fortunelabs-io/direct-semantic-comm/docs/dsc_first_principle.md

# Direct Semantic Communication on constrained hardware: a thinkbook

*Notes toward a two-node, two-sided, physically instrumented test of semantic payload transfer, written before any board has been flashed. Every number in this document that was not measured by this project is marked as borrowed. Borrowed numbers are expectations, not findings.*

---

## Preface

The parent build asked whether semantic enrichment via KV-cache transfer could be reproduced and fully understood from scratch, using models smaller than the paper's. It answered that question and produced a ledger: producing an enriched state is computation, moving it is communication, using it is computation again. It priced that ledger on a development machine and found the two sides pointing in opposite directions, compute favoring the exchange and communication opposing it by four to five orders of magnitude, with no way to adjudicate between them, because on that machine communication cost nothing.

What a development machine can produce is not a verdict but a threshold: the link speed above which the trade turns favorable, stated against both prompt and response length. That threshold is the last of the parent build's open items, recorded there as *the ledger reopened on constrained hardware, where the payload figure stops being free and the break-even table stops being arithmetic*.

This document is that item. It is not a derivative project. It is the only measurement that can adjudicate a question the parent build was structurally unable to answer.

The subject is no longer the KV-cache. The KV-cache does not fit on a microcontroller and neither does the machinery around it. What carries over is the shape of the trade the KV-cache experiment instantiated: whether transferring a representation that has already been understood is cheaper, in measured joules and milliseconds, than transferring raw data and forcing the receiver to understand it again.

One discipline carries over unchanged. No claim enters this document without either a local measurement or a citable source, and the two are never confused. The hardware harness described here is the physical analog of a capture script: until it runs on this project's own boards, every figure below is literature.

A second discipline carries over from the parent build's own failures. Predictions are recorded before the run that adjudicates them, in Section 7. Readings that measurement overturns are kept visible, not quietly corrected, because a claim that was corrected is worth as much as one that held.

---

## 1. Problem statement

Two microcontrollers share a low-power radio link. Node S has produced some internal state, a reading, a signal, a partial computation, sitting in its own SRAM. Node R needs to act on what that state means. Getting meaning from S's SRAM into R's decision requires one physical act: serialize the state into a payload, hand it to the radio, let the radio cut it into frames small enough to fit the link's hardware limit, transmit those frames one at a time, and let R reassemble and interpret them.

### 1.1 Why there are exactly three options

The choice of what to serialize is not a matter of taste, and it is not specific to microcontrollers. It is the composition question, and it has a known shape.

Combining the strengths of two systems requires choosing *where in the pipeline* the combination happens, and two classical answers occupy the endpoints. One communicates before computation, at the level of inputs or parameters: cheap to move, but the receiver must do all the work, and any work the sender already did is discarded. The other communicates after computation, at the level of outputs: minimal to move, but every contribution except the final one is destroyed at the source. Both endpoints are taken. Neither considers the middle.

Mapped onto the link, those endpoints are the first two options and the middle is the third:

1. S serializes its raw observation, unprocessed. R receives it and computes the result itself, from zero.
2. S computes the result fully, then serializes only the final decision, a single value or label.
3. S serializes an intermediate representation, distilled from the raw observation but not yet collapsed into a final decision.

The middle option is only viable if three things hold: there is an intermediate state rich enough to be worth transferring, that state is detachable from the process that produced it, and the receiver can interpret it despite not having produced it. A learned encoder satisfies the first two by construction, since a bottleneck activation is fully formed at a natural boundary and can be serialized. The third is the whole difficulty, and Section 3 splits it out as a separate hypothesis rather than assuming it away.

### 1.2 Why the middle is forced here rather than merely preferred

On a server the choice is unforced; both compute and bandwidth are cheap enough that any of the three works adequately. On an MCU pair two constraints bind at once and cannot be traded against each other in the usual way. First, the radio has a hard per-frame payload ceiling, and every frame, however small its contents, carries a fixed cost. Second, both S and R run on a milliamp-scale energy budget with no slack to spend on work that does not strictly have to be done.

Option 1 fails this pair in a specific way. Raw data is usually the largest of the three payloads, so it pays the most in frame overhead, and R still has to spend its own scarce energy reprocessing data that S may already have touched once. It is a double tax, paid on both ends of the same constrained link.

Option 2 fails differently, and the closest precedent concedes the failure in its own limitations section: processing on the device rather than sending means the raw data is lost for any later review, verification, or reanalysis, and where those are required the approach is unsuitable. That is not an outside criticism. It is the strongest existing measurement of Option 2 naming what Option 2 costs.

Option 3 is the only point in this design space where the cost paid at S, the cost paid on the link, and the cost paid at R can all be tuned together against the same two binding constraints, rather than relieving one by making the other worse.

### 1.3 The question

> On two ESP32-S3 nodes linked by ESP-NOW, does a learned intermediate representation clear both binding constraints at once, in measured joules and milliseconds, once the sender's encode cost and the receiver's decode cost are both charged against the frames it saves?

Everything below serves that question.

---

## 2. The gaps

Each gap is stated with the closest existing work and what that work stops short of. Where an earlier draft of this document overstated a gap, the correction is kept visible rather than silently applied.

### 2.0 Three constraint regimes, not one field

Three literatures look adjacent and are not, because each is pinned by a different binding constraint. Naming them first prevents the rest of this section from reading as three complaints about one body of work.

Split inference on MCUs (Lu et al., arXiv:2605.09357) is pinned by **peak RAM**. Its answer, sub-layer partitioning that bounds per-device memory, follows from that constraint and does not transfer, because its link is wired Ethernet and its metric is latency.

Embedded ML versus transmission (Karic et al., arXiv:2510.24829) is pinned by **transmission energy on one node**, the sensing node, and its answer is to send a class index over an LPWAN.

This project is pinned by **frame overhead and a two-sided energy budget on a connectionless short-range radio**. That is a third regime. The gaps below are consequences of it, not deficiencies in work that was answering something else.

**Gap 1: No two-sided ledger.** Karic et al. measure energy only on the sensing node. Their own text concedes that in the cloud-inference scenario only the IoT node is metered. The receiver's cost of consuming raw data versus consuming a distilled result is never measured anywhere in that line of work. The core claim of semantic communication is precisely a claim about the *sum* of both sides; a one-sided measurement cannot confirm or refute it.

**Gap 2: No representation between raw and decision, over a radio, with both sides metered.** Karic et al. transmit a class index: the final decision, Option 2 above. Lu et al. do transfer intermediate activations between MCUs, but over 100 Mbps wired Ethernet with TCP, through a PC coordinator, with no energy measurement anywhere; their own cost model has a compute term and a per-kilobyte communication term and no fixed per-transfer term at all. The intermittent-network study (arXiv:2512.24179) does move activations over ESP-NOW and does profile transmission energy, on one node, in a simulation-feeding profile. Nobody has transferred a learned intermediate representation between two MCUs over a radio while metering both nodes against a stated cost model.

*Correction to an earlier reading.* An earlier draft asserted that the split-inference line does not meter the radio at all. That is wrong for arXiv:2512.24179, whose Section 5.3 is a transmission energy profile per layer output over ESP-NOW. The gap survives in the narrower form stated above.

**Gap 3: No fragmentation curve.** This is now a statement about what two sources contain, not an absence of evidence.

The one peer-reviewed power-analyzer characterization of ESP-NOW found (Urazayev et al., IEEE SIST 2023) fixes its payload at **8 bytes** for every experiment. It is one point. There is no sweep.

Five further discrete points exist in the profiling appendix of arXiv:2512.24179, spanning payload sizes that straddle the ESP-NOW v1.0 single-packet boundary. They do not constitute a curve. There are no repetitions and no confidence bands; the sequence is non-monotonic in payload size with no explanation offered; two of the five rows fail an internal consistency check, in that the reported duration multiplied by the reported average power does not reproduce the reported total energy; and that paper's body text states a full-inference compute figure differing from the sum of its own layer-wise table by three orders of magnitude.

No published source provides a continuous, repeated, confidence-banded curve of energy per packet, or energy per byte, versus payload size across that boundary. The step structure at the fragmentation boundary, which is where the packet-count argument for semantic compression lives or dies, has never been drawn from measurement.

**Gap 4: No protocol match.** The LPWAN protocols in Karic et al. carry connection-establishment costs that dominate their energy profiles and have no analog in ESP-NOW; in their own measurements, network connection is the largest single term for the cellular protocols by a wide margin over the transmission itself. Their numbers do not transfer, and the term that dominates them does not exist here. Urazayev et al. establish that ESP-NOW undercuts a Wi-Fi TCP approach on power by more than thirty percent, and characterize a single transmission and its retransmission window, but at one payload size only.

**Gap 5: No cross-geometry bridging test on MCU pairs.** Every embedded precedent found here uses one designer's model split across devices, with encoder and decoder always optimized together. None tests the hard problem: a representation produced by one independently trained system, made usable by a second independently trained system through a small learned bridge, with both original systems frozen. Gaps 1 through 4 are closed by testing one jointly optimized system split across two devices. Gap 5 is closed only by a separate, later test where the two halves are trained independently and bridged, a deliberately narrower and later target than the first four.

**Gap 6: The compute cost of semantics is named but never priced.** The generalized semantic communication framework (Qin et al.) tabulates a cost row for semantic processing, listing sensing hardware, storage, and GPU, alongside its architectural framework. The theoretical survey (Xin, Fan and Letaief, *Entropy* 26(2):102) lists scheduling and energy optimization as an open challenge of semantic communication systems in its own words. The field names the computational price of semantics as a category and, so far as this search found, never pays it in joules on hardware where it binds. That is the space this project occupies, and it is a stronger positioning claim than novelty of mechanism.

A search across the semantic communication literature (Tsinghua, SJTU, XJTU groups), the split-computing literature, and the embedded ML literature found no work occupying the intersection of these gaps. The claim is not "this has never been done anywhere"; it is "this has not been found after a deliberate multi-tradition search." The distinction matters and is kept.

---

## 3. The proposed solution

The proposed solution treats Option 3 from Section 1 as two separate hypotheses, tested in sequence, never merged under one label.

**H_ledger** proposes splitting one jointly optimized encoder-decoder system across two physical devices. Encoder and decoder share one training objective by construction, so there is no representation-alignment problem to solve here, only a hardware cost to price.

- *Question*: does splitting one jointly trained encoder-decoder system across two physical nodes cost less, energy and latency on both sides, than sending raw data and having the receiver reprocess it, at equivalent delivered information?
- *Expected result*: H_ledger holds if $C_B < C_A$ per the inequality in 4.4, and $Q(B) \geq Q(A) - \varepsilon$ holds per sample under the sufficiency and collapse checks in 4.6. The boundary is not the sign alone; it is whether the measured margin matches the inequality's predicted direction and magnitude, reported as a fraction of the achievable range per 4.5.

**H_transfer** proposes the harder mechanism: a representation produced by one system that was never trained with the consumer in mind, made usable by a second, independent system through a small learned bridge. This is the variant with the alignment problem in it.

- *Question*: can a representation from an independently trained, frozen Encoder_S be made usable by an independently trained, frozen Decoder_R through a small trained Projector, at a bridging cost ($E_{\mathrm{proj}}$) that still leaves the total ledger favorable against raw transfer?
- *Expected result*: H_transfer holds if $C_{\mathrm{transfer}} < C_A$ per the inequality in 4.8 and the sufficiency and collapse checks pass. Because $E_{\mathrm{proj}} \geq 0$, this boundary is strictly tighter than H_ledger's; a small negative margin here is a meaningful failure in a way it would not be for H_ledger.

H_ledger is tested first, in Stages -1 through 4. H_transfer is tested second, in Stage 5, once the physical ledger itself is trusted. A result for H_ledger is not a result for H_transfer; the two are reported separately throughout.

One experiment, two conditions, four measured phases, both nodes metered.

**Condition A (raw transfer).** S transmits the raw payload. R receives it and runs the full processing step locally. The full processing step is the Condition B encoder and decoder at the contract point, run whole on R, per `2026-09-26-condition-a-runs-the-same-network-whole-on-r.md`. The two conditions then differ only in where the encoder runs and in what crosses the link. S pays no encode cost. The link pays for every raw byte, fragmented as needed. R pays full processing. At the contract point the compute premium of 4.4 is therefore close to zero, and H_ledger there measures the link saving almost alone. A model trained on raw data for R alone is a later sensitivity arm.

**Condition B (semantic transfer, H_ledger variant).** S runs a small learned encoder over the raw payload and transmits the latent representation. R runs the matching decoder, or consumes the latent directly for the task. S pays encode. The link pays only for the latent. R pays a reduced use cost. Encoder and decoder are trained together as one system and only split at deployment, so there is no representation-alignment problem here by construction.

### 3.1 The latent width is a design variable, and that is the premise of the whole argument

At the model tier the payload size is not a choice. A KV-cache is a consequence of architecture, of layer count, head count, head dimension, and precision, and cannot be tuned below any threshold. That is why the communication side of the parent build's ledger lost by four to five orders of magnitude with nothing available to do about it.

At this tier the bottleneck width is free. The latent can be sized and quantized to land wherever the designer puts it, including deliberately just under the frame limit $L$. The cut is fixed at an injected bottleneck, per `2026-09-26-search-space-is-bottleneck-width-and-bit-width.md`, so the width and the bit-width are the two design variables, and 4.9 states the search over them.

This is not a convenience. It is the premise on which the packet-count argument rests. The sawtooth in energy per byte is only *actionable* because there exists a design variable that can be placed on the cheap side of a discontinuity. Without that freedom the sawtooth would be an observation about a curve; with it, the sawtooth is a design target. Section 4.4 states the win condition in those terms.

### 3.2 R holds no local observation, and the replacement lesson does not transfer intact

In the parent build the consumer had its own reading of the same input, and the mechanism that worked added to it while every mechanism that substituted for it collapsed, twice, under two objectives, on two corpora, onto two different constant outputs. The lesson recorded there is that transferred understanding must complement and never overwrite.

That lesson does not transfer here in its stated form, and assuming it does would misdesign this experiment. The collapse observed there is destructive interference, and it requires the consumer to possess prior competence for the incoming representation to destroy. In Condition B and in Stage 5, R never observes the raw phenomenon. It has no competing reading to be overwritten, so there is nothing for a residual to preserve and substitution destroys nothing.

What does transfer, fully, is the *failure signature*: an output that collapses to a constant while an aggregate metric reads the collapse as partial success. That is not a property of substitution. It is a property of aggregate reporting, and it is guarded against in 4.6 rather than designed around here.

Giving R a cheap local observation would make this experiment a structural analog of the parent build's fused arm rather than its replacing arm, and that remains an interesting variant. It is not a correction, and it is not adopted in the core runs, because it changes the question from *what does a transferred representation cost* to *what does a transferred representation add*.

### 3.3 The encoder

The learned encoder is deliberately modest: an int8-quantized autoencoder of the kind already demonstrated on ESP32-class hardware. Novelty is not sought in the model. It is sought in the ledger.

Its energy is budgeted by measurement and never by operation count. The closest precedent measured a network with more floating-point operations consuming less energy than one with fewer, on this chip family, which is sufficient to retire the practice of estimating $E_{\mathrm{enc}}$ from FLOPs anywhere in this document.

### 3.4 Build discipline

Unix discipline governs the build. Each firmware and host component does one thing:

- `payload_gen`: produces payloads of a commanded observation size and content class. Nothing else.
- `fragmenter`: chunks a payload into ESP-NOW frames with one frame byte on each and a six-byte message header that holds a 16-bit sequence number and a CRC16, then reassembles and checks the message on the far side, per `2026-09-26-escp-header-layout.md`. Nothing else. Hand-rolled, so its compute cost is visible and chargeable, not hidden in a vendor component. The sequence number also carries the application-layer acknowledgement 4.6 requires, since a MAC-layer send success is not an application-layer delivery.
- `phase_marker`: toggles one GPIO per phase transition. Nothing else. This is not stylistic minimalism. The ESP-NOW send callback runs from a high-priority Wi-Fi task and the vendor documentation states that lengthy operations must not happen there, so the marker must be a bare register write and the analysis must happen on the host.
- `tx_role` / `rx_role`: two firmware images, one role each. No dual-mode switches. Ablation variants of each, per 4.2, are separate images rather than compile-time flags on one image.
- `meter_logger` (host side): reads the current trace and the GPIO edges, emits one CSV row per event. Text output, because text composes.
- `analyze` (host side): consumes CSV, emits statistics and plots. Never touches hardware.

Components communicate through flat files and serial text. Any single component can be replaced or audited without touching the others.

---

## 4. The mathematics and the architecture

### 4.1 Cost model

Let $p$ be payload size in bytes and $L$ the single-frame limit (`ESP_NOW_MAX_DATA_LEN`, 250 B under v1.0; `ESP_NOW_MAX_DATA_LEN_V2`, 1470 B under v2.0). Packet count is a ceiling function:

$$n(p) = \left\lceil \frac{p}{L} \right\rceil$$

That count is header-free. The ESCP header of `2026-09-26-escp-header-layout.md` puts `h_frag = 1` byte on every frame and `h_msg = 6` bytes once per message, so the count and the bytes on the wire become

$$n(p) = \left\lceil \frac{p + h_{\mathrm{msg}}}{L - h_{\mathrm{frag}}} \right\rceil, \qquad p_{\mathrm{wire}} = p + h_{\mathrm{msg}} + n(p)\,h_{\mathrm{frag}}$$

Every byte term in this document reads `p_wire` in place of `p`. The constants are fitted against `p_wire`, so no header byte is counted twice. The first frame boundary sits at `p = L − 7`, 243 bytes under v1.0 and 1,463 bytes under v2.0.

Transmit-side energy is modeled as three terms, not two:

$$E_{\mathrm{tx}}(p) = E_{\mathrm{wake}} + n(p)\cdot E_{\mathrm{pkt}} + p \cdot e_{\mathrm{byte}}$$

$E_{\mathrm{wake}}$ is everything paid once per *event* regardless of how many frames it takes: leaving sleep, bringing up the radio, the active window the MCU holds open, re-entering sleep. $E_{\mathrm{pkt}}$ is everything paid once per *frame*: preamble, the 43 bytes of ESP-NOW framing, the send callback, and whatever retransmissions the frame incurs. $e_{\mathrm{byte}}$ is the marginal air-time cost per payload byte at the configured PHY rate.

The receive side gets the mirrored model with its own constants:

$$E_{\mathrm{rx}}(p) = E'_{\mathrm{wake}} + n(p)\cdot E'_{\mathrm{pkt}} + p \cdot e'_{\mathrm{byte}}$$

**Why the wake term is separated.** An earlier version of this model folded the per-event cost into the per-frame term, and it could not have detected the difference, because a design in which every event is one wake confounds them exactly. The separation matters for three reasons.

The first is diagnostic. The only existing ESP-NOW energy data is consistent with a large fixed term of roughly the size of an active window multiplied by an idle current, and the only power-analyzer characterization puts an actual 8-byte transmission at about one millisecond, two orders of magnitude below that fixed term. If that reading is right, the dominant cost is *how long the MCU stays awake* rather than *how many frames it sends*, compute time and radio time compete for the same term, and the packet-count argument weakens sharply.

The second is that the wake asymmetry is not an open question but a protocol guarantee. Espressif's connectionless power-save model gives each connectionless module a Window and an Interval: at the start of each Interval, RF, PHY and BB are turned on and held for Window. The documentation states that transmission is supported at any sleeping time with no extra configuration, while reception requires the Window. **The sender can speak from sleep; the receiver must hold a window open to hear.** So $E'_{\mathrm{wake}}$ on R is a parameter this experiment sets rather than a property it discovers, it is independent of payload, and it is structurally unlike $E_{\mathrm{wake}}$ on S.

The third is structural, and it is the reason this separation is a decision rather than a refinement. The wake terms appear identically in both conditions and therefore *cancel in the difference*. They do not cancel in the range the difference is measured against. A term that the sign of the result normalizes away can still determine how much the result is worth, and reporting only the sign hides exactly that. Section 4.5 makes the range explicit.

**A note on $n(p)$ under v2.0.** The frame format documentation states that a v2.0 packet carries its payload as up to six vendor-specific elements, each with a seven-byte header and a body capped at 250 bytes. The 250-byte structure therefore does not disappear under v2.0; it moves from frame count into element count inside a single frame. Whether element count carries any cost beyond its seven bytes is unknown and is what the Stage 4 version control tests.

Total cost per delivered observation, both conditions:

$$C_A = E_{\mathrm{tx}}(p_{\mathrm{raw}}) + E_{\mathrm{rx}}(p_{\mathrm{raw}}) + E_{\mathrm{proc}}$$

$$C_B = E_{\mathrm{enc}} + E_{\mathrm{tx}}(p_{\mathrm{lat}}) + E_{\mathrm{rx}}(p_{\mathrm{lat}}) + E_{\mathrm{use}}$$

where $E_{\mathrm{proc}}$ is R's full processing of raw data, $E_{\mathrm{enc}}$ is S's encoder pass, and $E_{\mathrm{use}}$ is R's consumption of the latent. The same structure holds with $T$ substituted for $E$ throughout; energy and latency are two ledgers over one event stream.

### 4.2 How the terms are identified

Every quantity in 4.1 is identified by **experimental design across runs**, not by resolving the shape of the current inside one event. This is stated here, before the architecture, because it is what determines how much instrument the project needs.

**$E_{\mathrm{wake}}$ and $E_{\mathrm{pkt}}$: regression on $k$ payloads per wake window.** At fixed payload size, vary the number of payloads sent inside one wake window over $k = 1, 2, 4, 8, 16$ and measure the total energy of each whole event. The intercept is $E_{\mathrm{wake}}$ and the slope is $E_{\mathrm{pkt}}$. Each point is an integral, not a waveform. The vendor documentation requires waiting for each send callback before the next send, so $k$ scales wall-clock time and the fit must include that.

**$e_{\mathrm{byte}}$: the payload sweep.** Slope of total event energy against $p$ within a frame. Again integrals.

**The retransmission share of $E_{\mathrm{pkt}}$: broadcast against unicast.** ESP-NOW unicast expects an acknowledgement and retransmits, up to ten times by default and up to thirty-one if configured; the only power-analyzer characterization found puts a failed transmission's retransmission window at roughly twelve milliseconds against a successful transmission of roughly one. ESP-NOW broadcast is not acknowledged and therefore does not retransmit. **Running the same sweep in both modes isolates the retransmission term from the frame term.** It costs nothing but a change of peer address and it attacks the largest unexplained quantity in the borrowed data.

**$E_{\mathrm{enc}}$, $E_{\mathrm{proc}}$, $E_{\mathrm{use}}$: firmware-variant ablation.** Rather than segmenting one event into phases, run separate firmware images that perform strict subsets of the event, on identical wake and sleep structure, and difference their totals. An encode-only image and a transmit-only image, differenced against the full Condition B image, give the encode term without ever requiring the meter to resolve where encode ends and transmit begins. Short operations are measured by repeating them a commanded number of times within one event and taking the slope, which is more accurate than any single-shot capture would be.

**Consequence.** The critical path of this experiment is the *number and design of runs*, not the bandwidth of the instrument. The meter must integrate an event faithfully. It does not have to draw one. Section 4.7 states what that buys and what it costs.

### 4.3 Every energy figure is reported decomposed

No total is reported without its decomposition into the part that scales with payload and the part that does not, and the two must sum to the measured total with the residue stated explicitly. A residue that is not near zero is a modeling error, and it is found here or it is found nowhere.

This is the physical form of a discipline the parent build arrived at one tier up, where a falling total loss coexisted with a rise in the only component that could change an answer. A total that improves is not evidence that the mechanism under test did anything.

### 4.4 The claim under test

Semantic transfer wins if and only if:

$$E_{\mathrm{enc}} + E_{\mathrm{use}} - E_{\mathrm{proc}} \;<\; \left[ n(p_{\mathrm{raw}}) - n(p_{\mathrm{lat}}) \right]\left( E_{\mathrm{pkt}} + E'_{\mathrm{pkt}} \right) + \left( p_{\mathrm{raw}} - p_{\mathrm{lat}} \right)\left( e_{\mathrm{byte}} + e'_{\mathrm{byte}} \right)$$

The wake terms have canceled. Left side: the net compute premium of the semantic path. Right side: the communication savings, split into a packet-count term and a byte-count term. Per 4.1 the byte-count term reads `p_wire`. The message-header bytes cancel in that difference, and each frame saved also saves its frame byte.

The central hypothesis, H1, is that on a low-power connectionless radio the packet-count term dominates the byte-count term, so the win condition is governed by whether the latent fits in fewer frames, not merely fewer bytes. Under H1, $E(p)/p$ is sawtooth-shaped: falling within each frame, jumping where $n(p)$ steps, at `p = k(L − h_frag) − h_msg` for each `k`, the first at 243 bytes under v1.0.

H1 is only *actionable* under the premise of 3.1. If $n(p_{\mathrm{raw}}) = n(p_{\mathrm{lat}})$ the packet-count term is identically zero and the entire argument reduces to the byte-count term, which is the weaker claim H1 exists to strengthen. Confirming that the packet-count term is non-zero for the chosen sensor modality and bottleneck width is arithmetic on datasheet constants, costs nothing, and is therefore Stage -1 rather than a discovery.

The two ESP-NOW versions predict different step mechanisms and this is a sharper test than the earlier framing of the same control. Under v1.0, crossing $L$ produces genuinely separate frames, each with its own acknowledgement and its own retransmission opportunity, so the step should be large. Under v2.0, crossing 250 bytes produces an additional vendor-specific element inside one frame, costing seven bytes and no additional acknowledgement, so the step should be small or absent. Observing a large step under both would falsify the account, not confirm it.

H0 is the flat alternative: energy per byte constant or rising in $p$, which would collapse the packet-count argument entirely and must be excluded first. Section 4.9 states the claim over the width search, where this inequality is evaluated once per candidate.

### 4.5 The null, and what a result is reported against

An energy saving reported as a fraction of $C_A$ is uninterpretable, because it does not say how much saving was available.

Define the null as the cost of a delivered event carrying a one-byte payload with no compute charged on either side:

$$C_{\mathrm{null}} = E_{\mathrm{tx}}(1) + E_{\mathrm{rx}}(1)$$

This is the floor. No representation, however compact, can cost less than an empty event. The reported quantity is therefore the fraction of the available range that the semantic path recovers:

$$G = \frac{C_A - C_B}{C_A - C_{\mathrm{null}}}$$

$G = 1$ means the semantic path costs as little as sending nothing. $G \leq 0$ means no gain. The denominator is measured, not assumed, and it is measured at Stage 1, before any encoder exists.

The reason this is a gate rather than a presentation choice: if $C_{\mathrm{null}}$ turns out to be most of $C_A$, then the entire achievable range is small, and a perfect encoder saves whatever is left. That is a verdict on the direction, and it costs one cheap run to obtain. Discovering it at Stage 3, after an encoder has been trained and deployed, would be discovering it at roughly a hundred times the price.

Without measuring the null first, a favorable difference has no reference and cannot be distinguished from a difference that was always going to be small.

### 4.6 Sufficiency, and the collapse check

Let $Q(\text{condition})$ be the task metric computed on R. The efficiency comparison is admissible only where:

$$Q(B) \geq Q(A) - \varepsilon$$

with $\varepsilon$ declared before any run. Without this constraint the experiment degenerates into "sending less costs less," which is true, trivial, and not the question.

The aggregate metric is not sufficient on its own. A decoder that has collapsed onto a constant output scores the base rate of whatever it settled on, and against a loose $\varepsilon$ that base rate can pass. The parent build produced exactly this: a figure that was read as a degraded accuracy and was in fact the frequency of one answer in a system that had stopped reading the question. Only per-sample records separated the two; the aggregate could not.

Three things are therefore required alongside $Q$, and no efficiency number is admitted without them:

- **Per-sample records**, written for every event, in both conditions, on identical inputs.
- **The output distribution of R** under both conditions, and its total variation distance from the reference label distribution. A collapse is visible here and invisible in $Q$.
- **Application-layer delivery confirmation.** The vendor documentation states that a send callback returning success means the frame was received at the MAC layer, and that it is not guaranteed the application layer received the data. A sample whose delivery was never confirmed by R's own acknowledgement is excluded from $Q$ and reported separately as a loss, never silently counted as an error.

### 4.7 System architecture and metering

```
Node S (ESP32)                          Node R (ESP32)
+--------------------+                  +--------------------+
| payload_gen        |                  |                    |
| [encoder: B only]  |                  | fragmenter (rx)    |
| fragmenter (tx)    |   ESP-NOW        | [decoder: B only]  |
| esp_now_send       | ===============> | [processor: A only]|
| phase_marker GPIO  |   n(p) frames    | phase_marker GPIO  |
+---------+----------+                  +---------+----------+
          |                                       |
     current sense on                       current sense on
     the 3.3V rail                          the 3.3V rail
          |                                       |
          +------------> meter_logger <-----------+
                              |
                          CSV rows
                              |
                          analyze
```

Phase boundaries on S: sleep, wake, encode, transmit, sleep. On R: sleep, wake, receive, decode or process, sleep. The wake and sleep transitions are marked as their own phases rather than folded into idle, because 4.1 charges them their own term. Each transition is one GPIO edge. No shared clock between nodes is required: one-way latency is taken from the meter side, which must see both nodes' phase markers on one timebase, and is cross-checked against RTT measured on S alone.

**Metering.** The core runs use a two-channel harness built for this experiment: one current sensor on each node's 3.3 V rail, and one capture engine that timestamps both sensors' conversion-ready edges and both nodes' phase markers against a single clock.

The single clock is the reason the harness exists. Commercially available low-power current meters in the price class this project can reach measure one rail. Two of them give two timebases with no shared reference, and stitching those together is an assumption rather than a measurement. A two-sided ledger cannot be built on an assumption about time, and Gap 1 may persist in the literature partly for that reason: the standard instrument meters one node, and so the published work meters one node.

The sensors are INA226 parts, chosen as catalog components rather than as an instrument. Everything above them, the capture engine, the timebase, the wire protocol, the calibration procedure and the host tooling, belongs to this project and can be reproduced by anyone reading the published design. The sensor can be substituted later without touching any other layer, which is the point of drawing the boundary there.

Sensor configuration, all of it forced by the datasheet rather than chosen:

- **Shunt-only continuous mode** at the fastest conversion time, 140 microseconds, with averaging set to one. The power-on default is 1.1 milliseconds on each of shunt and bus with shunt-and-bus continuous mode, roughly 2.2 milliseconds per pair, which is longer than an entire 8-byte transmission and would render the transmit phase invisible.
- **Supply voltage measured once per run, DUT rail computed per sample.** Only the supply upstream of the shunt is treated as constant. The rail the DUT actually sees is that supply minus the shunt drop, which at 0.1 ohm and a 330 mA transmit peak is 33 millivolts, one percent. Treating the DUT rail itself as constant would put that one percent straight into every transmit-phase power figure. The correction is exact and free, since the current is already measured: the DUT rail per sample is the supply minus the measured current times the measured shunt value. A periodic bus-voltage conversion, roughly one sample in a hundred, monitors the supply assumption at one percent of the conversion budget rather than assuming it.
- **Fast-mode I2C at 400 kHz, one bus per channel, with the register pointer retained.** The datasheet states the pointer persists until a write changes it, so repeated reads of the shunt voltage register do not resend it. That brings a read to roughly seventy-three microseconds against a hundred and forty microsecond conversion, about half the budget, and two channels on two buses fit. Rewriting the pointer each time costs eighty-six percent and two channels on one bus fails outright. High-speed mode at 2.94 MHz is the fallback if measured margin is worse than this arithmetic, not the starting point.
- **Alert pin configured as Conversion Ready** (the CNVR bit of the Mask/Enable register), routed into the capture engine alongside the phase markers. The INA226 timestamps nothing and I2C reads are not deterministic, so without a hardware edge per completed conversion there is no honest way to place a sample in time. This is the interface between the catalog sensor and the part of the harness this project owns.
- **Alert latch set to transparent**, so the conversion-ready flag self-clears and no Mask/Enable read is needed per conversion. This halves the edge rate into the capture engine and removes one bus transaction per sample.
- **Shunt voltage register only.** Bus voltage is not converted, the calibration register is never programmed, and current is computed on the host where the shunt value is auditable.
- **Kelvin, four-wire connection to the shunt**, per the datasheet layout guidance.

Two limits are stated here rather than discovered later:

**Temporal resolution.** The front end is delta-sigma and its output is an average over the conversion window, not an instantaneous sample. A conversion straddling a phase boundary blends the two phases. Phase boundary location therefore carries an intrinsic uncertainty of one conversion time, roughly a hundred and forty microseconds, which against a transmit phase of order one millisecond is on the order of ten percent. Every quantity in 4.2 is an integral over an event of tens of milliseconds, where this uncertainty is negligible; no quantity in this document depends on locating a boundary more precisely than that.

**Deep sleep is a blind spot.** The INA226 is a fixed-range device with roughly thirty-two thousand counts and no automatic ranging. A shunt sized to keep transmit peaks on scale places deep-sleep current at or below one least significant bit. Sleep current is therefore not measured. It is identical across conditions and cancels in every comparison this document makes, and every term in 4.1 is an awake-window quantity, so the omission is stated rather than corrected. Any absolute battery-lifetime claim would need a ranging front end, and this document makes none.

Closing that blind spot is an analog design problem, not a timebase problem, and it is deliberately not attempted in this revision. It is gated on Stage 2 data showing that the range actually binds. Building it first would combine a higher cost of failure with a skill not yet established, on a question that has not yet been asked.

Operating constraints fixed and **declared for all runs**: pure ESP-NOW with no AP association; Wi-Fi power save off; single fixed channel; fixed board positions and orientation; unencrypted frames in the core runs; and the connectionless Window and Interval, recorded per run because 4.1 charges R's wake term to them.

The no-AP constraint is a chosen trade with a price. The vendor documentation notes that when sender and receiver associate with the same access point, the Interval start aligns with the beacon interval and transmitting inside the wake-interval-start event raises reception success. Refusing association buys measurement simplicity and costs R either a wider receive window or lost packets. That cost is real, it lands entirely in $E'_{\mathrm{wake}}$, and it is named here so that it is not later mistaken for a property of the protocol.

### 4.8 The transfer variant (H_transfer)

Condition B's model has one encode term and one use term because the encoder was built to be read by that exact decoder. H_transfer removes that assumption. Encoder_S and Decoder_R are trained independently, frozen afterward, and a small Projector is the only component allowed to adapt across the boundary. This physically mirrors the training protocol the parent build reconstructed and reproduced: both endpoints frozen, only the bridge trained.

```
Node S (ESP32)                          Node R (ESP32)
+--------------------+                  +--------------------+
| Encoder_S [frozen] |   ESP-NOW        | fragmenter (rx)    |
| fragmenter (tx)    | ===============> | Projector [trained]|
| phase_marker GPIO  |   n(p) frames    | Decoder_R [frozen] |
+--------------------+                  | phase_marker GPIO  |
                                        +--------------------+
```

$$C_{\mathrm{transfer}} = E_{\mathrm{enc}}^{\mathrm{frozen}} + E_{\mathrm{tx}}(p_{\mathrm{lat}}) + E_{\mathrm{rx}}(p_{\mathrm{lat}}) + E_{\mathrm{proj}} + E_{\mathrm{use}}^{\mathrm{frozen}}$$

$E_{\mathrm{proj}}$ is charged to R because the Projector executes on R. It is charged there for that reason and no other; an earlier draft justified the placement by appeal to the receiver's local context, which R does not have in this design, per 3.2.

The win condition against Condition A's raw baseline becomes:

$$E_{\mathrm{enc}}^{\mathrm{frozen}} + E_{\mathrm{proj}} + E_{\mathrm{use}}^{\mathrm{frozen}} - E_{\mathrm{proc}} \;<\; \left[ n(p_{\mathrm{raw}}) - n(p_{\mathrm{lat}}) \right]\left( E_{\mathrm{pkt}} + E'_{\mathrm{pkt}} \right) + \left( p_{\mathrm{raw}} - p_{\mathrm{lat}} \right)\left( e_{\mathrm{byte}} + e'_{\mathrm{byte}} \right)$$

The right side is unchanged, since the communication savings do not care who trained what. The left side gains one non-negative term that H_ledger's inequality never had to pay. Because $E_{\mathrm{proj}} \geq 0$, H_transfer's break-even bar is never easier to clear than H_ledger's. Whatever margin Stage 3 records for H_ledger is an upper bound on H_transfer's margin, not a proof of it, and the two numbers must not be quoted interchangeably.

One structural note carried down from the parent build. If Encoder_S emits a latent much narrower than what Decoder_R expects, the Projector should widen it before combination rather than be expected to compensate inside the combination. The parent build found the producer occupying roughly a ninth of the channels entering the bridge purely as a consequence of architecture, before any learning, and the source's own stronger variant equalizes the widths first. That is a configuration fact, readable before training, and it belongs in Stage -1.

The sufficiency and collapse constraints of 4.6 carry over unchanged in form but are a strictly harder test in practice, since $Q$ is now computed through a decoder that never saw this encoder during its own training.

### 4.9 The width decision

The latent of Condition B is a family of designs. Per `2026-09-26-search-space-is-bottleneck-width-and-bit-width.md`, the cut is fixed at an injected linear bottleneck, and the design variables are its width `w` and the bit-width `b` of each transmitted element, drawn from declared candidate sets `𝒲` and `𝔅`. The inequality of 4.4 then holds or fails once per candidate, and the claim under test is a statement about the cheapest candidate that keeps quality.

At a window length `W`, a candidate `(w, b)` sends a latent of

$$p_{\mathrm{lat}}(w, b) = \left\lceil \frac{w\,b}{8} \right\rceil$$

bytes and costs

$$C_B(w, b) = E_{\mathrm{enc}}(w, b) + E_{\mathrm{tx}}\bigl(p_{\mathrm{lat}}(w, b)\bigr) + E_{\mathrm{rx}}\bigl(p_{\mathrm{lat}}(w, b)\bigr) + E_{\mathrm{use}}(w, b)$$

with $C_A$ as in 4.1. Every term is taken at the same `W`, and the encoder, use, and processing terms depend on `W` because each processes a whole window.

The feasible set keeps the candidates whose quality at R stays within `ε` of Condition A, per 4.6.

$$F = \bigl\{ (w, b) \in \mathcal{W} \times \mathfrak{B} \;\bigm|\; Q(w, b) \geq Q(A) - \varepsilon \bigr\}$$

The chosen configuration is the cheapest feasible candidate.

$$(w^*, b^*) = \operatorname*{arg\,min}_{(w, b) \in F} \; C_B(w, b)$$

The verdict takes one of three values, per `2026-09-26-partition-decision-returns-three-verdicts.md`.

$$v = \begin{cases} \mathrm{A\_QUALITY} & \text{if } F = \varnothing \\ \mathrm{B\_WINS} & \text{if } F \neq \varnothing \text{ and } C_B(w^*, b^*) < C_A \\ \mathrm{A\_COST} & \text{if } F \neq \varnothing \text{ and } C_B(w^*, b^*) \geq C_A \end{cases}$$

The three cases are exhaustive and exclusive. Because `(w*, b*)` minimizes `C_B` over `F`, `B_WINS` holds if and only if the inequality of 4.4 holds for at least one feasible candidate. The two ways Condition A can win point at different fixes. `A_QUALITY` points at the extractor. `A_COST` points at the link economics, the window length, or the width set.

The same decision holds with latency in place of energy. Which of the two it minimizes is declared before the run, together with `ε`.

Stage 3 evaluates the decision with `𝒲 = {64}` and `𝔅 = {8}`, where it reduces to the inequality of 4.4 at one point. Stage 3b evaluates it over the widths that pass the host-only frontier of Section 5. Per `2026-09-26-condition-a-runs-the-same-network-whole-on-r.md`, `Q(64, 8)` equals `Q(A)`, so the contract point is always feasible and `A_QUALITY` cannot occur in the core runs.

The inputs of the decision are measured before the run that adjudicates it. Its value for every candidate, not only the chosen one, is recorded before that run, per Section 7. The procedure that evaluates it, and the files it reads and writes, are specified in the HLD, Appendix C.

---

## 5. Proof steps

Each stage is named by the condition it can kill and ordered by the cost of killing it, not by the order components appear in the system. The last column is the one that makes the ordering load-bearing: it states what becomes void if that stage fails after later stages have already been paid for.

**The harness build sits outside this ladder.** Constructing the instrument of 4.7 costs weeks and a fabrication run, which is more than Stage 1 and possibly more than Stage 2, so treating it as a stage would break the ordering the table depends on. It is capital expenditure, not a hypothesis: it kills no condition and answers no question. Stage 0 is the harness's acceptance test, not its construction, and as a gate it costs days once the instrument exists.

That split leaves one exposure worth naming. A phase that produced its own artifact and then judged it would have no independent gate, and the parent build was bitten by exactly that shape: a probe that passed for a full run while comparing the wrong quantity, written by the same hand as the thing it probed. The mitigation is that Stage 0's instrument checks reference standards outside the harness, a precision resistor and an independent voltmeter for gain, the device under test's own clock for timing. The validator is a resistor rather than a judgment, and that is what makes self-validation admissible here.

| Stage | What it can kill | Cost | Void if it fails late |
|---|---|---|---|
| -1 | The packet-count term exists at all | Arithmetic, no hardware | The entire H1 argument, and with it the reason to prefer Option 3 over a byte-count argument |
| 0 | The harness measures the thing it is pointed at, on one honest timebase | Days, once the harness exists | Every number in the project |
| 1 | The available range is worth chasing | One cheap run | The direction; Stages 2 onward are then unfunded |
| 2 | The frame boundary has a step, separable from the wake and retransmission terms | The long sweep | The cost model's structure |
| 3 | The two-sided ledger favors the latent | Encoder training and deployment | H_ledger |
| 3b | A width or bit-width other than the contract's lowers the ledger further within `ε` | One training run per width with several seeds, and one image pair per window length and width | The width recommendation only. H_ledger at the contract point stands |
| 4 | Each model term survives its own control | Repeats of Stage 3 key points | The attribution of any Stage 3 result to a named term |
| 5 | A bridge can carry a representation across independently trained halves | A second training regime | H_transfer only |

**Stage -1: the configuration contract.** Before any board is flashed, and before any hardware is bought. This stage is arithmetic over declared constants and it settles five questions.

Does $n(p_{\mathrm{raw}}) - n(p_{\mathrm{lat}}) \geq 1$ hold for the chosen sensor modality at the candidate bottleneck width and quantization? If raw and latent both fit in one frame, the packet-count term is identically zero, H1 has nothing to say, and the experiment must either change modality, change $L$ by changing ESP-NOW version, or be re-scoped to a byte-count claim.

Do both nodes run the same ESP-NOW version? A v1.0 device receiving a v2.0 packet longer than `ESP_NOW_MAX_IE_DATA_LEN` will truncate the data to the first `ESP_NOW_MAX_IE_DATA_LEN` bytes or discard the packet. The interop boundary is a third length constant, distinct from both `ESP_NOW_MAX_DATA_LEN` and `ESP_NOW_MAX_DATA_LEN_V2`. Silent truncation presents as a decode failure rather than a link failure and would cost a week to localize.

Do Encoder_S and Decoder_R agree on quantization scheme, scale granularity, and tensor layout? A per-tensor scale on one side and a per-channel scale on the other is a contract mismatch no amount of bridge training absorbs cleanly, and it is readable from two configuration files.

What is the width ratio between the transmitted latent and what the decoder expects, per the note in 4.8?

What shunt value keeps the expected transmit peak on scale, and where does that place the resolution floor? This is arithmetic over the INA226's full-scale shunt voltage and least-significant-bit against the chip's active current, and it produces the stated blind spot of 4.7 as a number rather than a hope. Closed: 0.1 ohm on both channels, high-side, resolving transmit to over thirteen thousand counts and placing deep sleep at a third of one count. Recorded with its derivation in the harness signal inventory and timing budget.

Deliverable: one table of declared constants and five answers, plus the harness signal inventory and timing budget, which fixes the capture engine class and the I2C bus count before any part is ordered. Cost: an afternoon and no equipment.

**Nothing downstream begins while any of the five is open, and that includes building the harness.** This stage exists to kill the direction for the price of an afternoon; the harness build is the first substantial expenditure the project makes. Starting the expensive thing while the free gate is still open inverts the ordering the rest of this section depends on, and the fact that the instrument could be specified without the answer does not restore it.

**Stage 0: instrument validation, three halves.** Before any experimental claim, prove the meter. Earlier drafts named two halves; the metering choice of 4.7 adds a third, and none may be skipped.

The first half is the no-op: reproduce a known static load within tolerance, verify frame delivery, verify the phase-marker edges and the conversion-ready edges both appear in the capture. A harness reading the wrong rail, or with its sense resistor on the far side of the regulator, or with an unconnected GPIO, can produce a trace that looks entirely plausible and is entirely stable.

The second half is the negative control, which distinguishes a working meter from a meter measuring something else that happens to be steady. Command a change of known size and require the trace to move by the predicted amount: a busy loop of commanded duration must produce an integral proportional to that duration, and with the radio disabled the transmit-phase integral must *collapse*. The last of these proves the phase markers bracket what they are believed to bracket.

The third half is the instrument check, and it is heavier here than it would be with a bought meter, because the harness of 4.7 has never been validated by anyone. With a commercial instrument this stage validates the wiring against a meter the field already trusts. Here it validates the meter as well.

Three claims must be established against references outside the harness. Gain and offset, against a precision resistor and an independent voltmeter, which gives a traceable DC point. Timing, against pulse widths commanded by the device under test's own clock, which the harness must reproduce within a stated tolerance. Bandwidth, by commanding a load that toggles at a known period near the conversion time and confirming the recorded trace reproduces the commanded duty cycle rather than smearing it. Alongside these, confirm no conversions are dropped over a full event by counting conversion-ready edges against samples logged, and confirm the rail voltage is stable enough across an event to be treated as a constant.

Those three references are standards rather than instruments, and that is the point. Agreement between two instruments is a cross-check; traceability runs to standards. A precision resistor and a crystal-derived pulse train are the stronger reference, not a cheaper stand-in for one. A borrowed commercial meter, if one is available, adds a cross-check on the single-rail case and nothing more; it is not a dependency and it does not enter the method.

The question asked of this gate, and of every gate after it: what would make this check pass while comparing the wrong quantity? The parent build ran a full training arm on a probe that passed correctly for a full run while comparing against the wrong baseline, so this question is asked in writing and answered in writing.

Deliverable: the control traces, the gain and timing references with their residuals, the dropped-conversion count, and one segmented event plot annotated with its own boundary uncertainty. The plot is illustrative. Earlier drafts made a clean single-event waveform the deliverable of this stage; at 4.7's resolution it is a coarse one, and per 4.2 nothing downstream depends on it.

This deliverable is also the harness's own first result. If it cannot be produced, the harness is not an instrument yet and nothing measured with it counts.

**Stage 1: the null and the direction probe.** Two questions, one cheap run, raw transfer only.

First, measure $C_{\mathrm{null}}$ per 4.5: the empty event, one byte, no compute, both nodes metered. Report $C_{\mathrm{null}}/C_A$ at the smallest and largest raw payloads under consideration. If the floor is most of the cost across that whole span, the achievable range is narrow, and that is a verdict on the direction obtained for the price of one run.

Second, at three or four payload sizes, roughly 50 to 100 packets each: does $E(p)/p$ fall within a frame (H1-shaped) or stay flat (H0-shaped)? If H0, stop and rethink; the remaining stages assume H1.

**Stage 2: the fragmentation curve, with the fixed terms separated.** Full payload sweep across the frame boundary, at least 1000 packets per size, both nodes metered, raw transfer only. Two controls interleaved with the sweep, per 4.2:

The $k$-payloads-per-wake regression, at fixed payload size, fitting $E_{\mathrm{wake}}$ as intercept and $E_{\mathrm{pkt}}$ as slope. Without this the sweep produces a curve whose fixed term cannot be attributed.

The broadcast-against-unicast pair, at each swept size, separating retransmission energy from frame energy. Broadcast carries no acknowledgement and therefore no retries; unicast retries up to its configured limit. The retry limit itself is recorded per run.

Report median, P95, P99 per size; the latency distribution is expected heavy-tailed, and under unicast the tail is expected to be governed by retry count rather than by payload size. Deliverable: the sawtooth curve with confidence bands, TX-side and RX-side plotted separately, with $E_{\mathrm{wake}}$ and the retransmission share reported as their own quantities. This is the project's first novel artifact regardless of what comes after.

**Stage 3: the two-sided ledger, swept (H_ledger).** Introduce the jointly trained encoder on S and the matching decoder on R. Stage 3 runs at the contract point, width 64 at int8, and Condition A runs the same network whole on R (Section 3). Run Conditions A and B on identical input sets. Charge every phase to its node, by firmware-variant ablation per 4.2 rather than by intra-event segmentation. Verify the sufficiency, collapse, and delivery checks of 4.6 per sample before admitting any efficiency comparison.

This stage is a sweep, not a point. The two payloads do not scale with the same quantity: $p_{\mathrm{raw}}$ scales with the observation, with sensor resolution and window length, while $p_{\mathrm{lat}}$ is a design constant independent of it. The compression ratio is therefore a free variable, and the sign of the result at any single operating point says nothing about where the ledger turns. Sweep the observation size across at least the range that moves $n(p_{\mathrm{raw}})$ through two frame boundaries.

Deliverable: $C_A$ against $C_B$ with all terms itemized and the decomposition of 4.3 residue-checked, $G$ per 4.5 with confidence intervals, the ablation error budget stated, and the observation size at which the ledger crosses. This stage resolves H_ledger only.

**Stage 3b: the width sweep (H_ledger).** Per `2026-09-26-width-sweep-is-stage-3b.md`. Before the first Stage 3 run on the harness, the host trains each candidate width with several seeds and evaluates `Q` at each bit-width, with no hardware. A width enters Stage 3b only if some bit-width keeps `Q` within `ε` of Condition A on that frontier. Stage 3b then measures the cost of the widths that pass, after Stage 3 passes its gates. Stages 4 and 5 depend on Stage 3 and not on Stage 3b. If no width other than 64 passes, Stage 3b does not run, and the frontier is the finding. A failure here voids the width recommendation only.

**Stage 4: controls (H_ledger).** Repeat key points with and without CCMP encryption; at the default 1 Mbps versus a raised PHY rate, which `esp_now_set_peer_rate_config()` sets per peer; under a varied connectionless Window and Interval, since 4.1 charges R's wake term to them; and under v1.0 framing versus v2.0 framing, which per 4.4 changes the mechanism producing the step and not merely the position of $L$. Each control isolates one term. A model term that survives its control is measured; one that does not is a modeling error found early.

**Stage 5: the transfer variant (H_transfer).** Gated on Stages 3 and 4 having produced a trusted, controlled H_ledger result. Train Encoder_S and Decoder_R separately, on separate objectives, ideally with a deliberate architectural difference so their latent geometries are not accidentally compatible. Freeze both. Train only the Projector. Measure $C_{\mathrm{transfer}}$ per 4.8, verify sufficiency, collapse and delivery per sample before any efficiency claim, and report the break-even margin against Stage 3's H_ledger margin explicitly, not in its place.

A negative result here, ledger favorable but transfer unusable, or transfer usable but ledger unfavorable, is still an answer to the question this thinkbook exists to ask, and localizes cleanly to either the bridge or the radio.

**Statistical discipline throughout.** Paired comparisons on identical inputs where possible; bootstrap confidence intervals on medians; no representation-sufficiency number reported before its per-sample audit and collapse check; no energy number reported from a run whose decomposition residue failed; no ablation-derived term reported without its propagated error. First cycle of every run discarded as warm-up, following the precedent methodology.

---

## 6. Builder knowledge

Three tiers. The primary tier is load-bearing: specifications and peer-reviewed measurements this design directly depends on, plus this project's own validated findings. The secondary tier is methodological: repos and papers whose techniques are adopted or adapted. The tertiary tier is contextual: surveys and community writing that orient but never justify a design decision. A claim may cite downward for color, never upward for support.

### primary-tier source

| Source | What it anchors |
|---|---|
| ESP-IDF Programming Guide, ESP-NOW API reference | Frame format (24 B MAC header, 1 B category code, 3 B organization identifier, 4 B random values, 4 B FCS, plus a 7 B vendor-specific element header, summing to the 43 B Urazayev et al. measure independently); the three length constants `ESP_NOW_MAX_DATA_LEN`, `ESP_NOW_MAX_DATA_LEN_V2` and `ESP_NOW_MAX_IE_DATA_LEN`; the v2.0 six-element structure behind the note in 4.1; default 1 Mbps bit rate; per-peer rate config; the statement that MAC-layer send success is not application-layer delivery; and the callback discipline behind 3.4. |
| ESP-IDF Programming Guide, Wi-Fi Performance and Power Save, connectionless modules section | Window and Interval semantics; that TX is supported at any sleeping time while RX requires the Window; the AP-association alignment this project declines. The protocol basis for the wake asymmetry in 4.1 and the declared trade in 4.7. |
| Espressif, "Current Consumption Measurement of Modules" | The official metering methodology and its own warning that the dynamic range from sleep to active defeats ammeters that cannot range quickly. Stage 0 follows it, adds the negative control it does not require, and 4.7 states the blind spot it predicts. |
| Texas Instruments, INA226 datasheet (SBOS547B) | Conversion times from 140 microseconds to 8.244 milliseconds; averaging from 1 to 1024; the power-on default of 1.1 milliseconds on each of shunt and bus; delta-sigma front end and the resulting window-average semantics; the Conversion Ready flag and its routing to the Alert pin; I2C fast and high-speed timing; shunt full-scale and least-significant-bit; Kelvin connection guidance. Every configuration choice and both stated limits in 4.7 come from here. |
| ESP32 Series Datasheet | Ceiling figures for TX/RX current, used at Stage -1 to size the shunt (borrowed, upper envelope only, never cited as per-event energy). |
| Karic et al., arXiv:2510.24829 | The phase-segmented metering methodology on this chip family. Source of Gap 1 by its own stated limits, and of Gap 2's first half. Also the source of two rules adopted here: that operation count does not predict energy on this hardware, and that on-device processing discards the raw observation, the latter being Option 2's cost stated by its strongest advocate. |
| Urazayev et al., IEEE SIST 2023, DOI 10.1109/SIST58284.2023.10223585 | The one peer-reviewed power-analyzer characterization of ESP-NOW. Anchors the 43-byte framing overhead independently of the vendor documentation; the roughly one-millisecond duration and 600 to 660 mW draw of a successful 8-byte transmission; the roughly twelve-millisecond retransmission window behind the broadcast control in 4.2; the ten-by-default retry limit; and the greater-than-thirty-percent power advantage over Wi-Fi TCP that closes Gap 4's first half. Its fixed 8-byte payload is what makes Gap 3 a statement of fact. |
| Lee, Lee and Ko, arXiv:2512.24179, section 5.3 | Per-payload ESP-NOW transmission energy over five points. **Quarantined:** two of five rows fail the duration times power equals energy check, the body text and the layer table disagree by three orders of magnitude on compute, and the implied compute throughput is implausible for the stated core. No figure from this source is used as a value; it is used to establish that the fixed per-event term is large enough to require the treatment of 4.1. |
| Parent build, `cache-2-cache-lite`, `FINDINGS.md` | The validated Python-tier result that a representation crosses an independently trained boundary and carries value, under paired statistics with per-sample records. Also the source of three disciplines adopted here verbatim in form: the null before the trained comparison, the decomposition of a total into the part the grader can see and the part it cannot, and the collapse signature that an aggregate cannot detect. Its third open item is this document. |
| Fu et al., C2C (ICLR 2026), section 3.3.4 | The freeze-both-then-train-only-the-bridge protocol Stage 5 physically mirrors. **Scope note:** this anchors H_transfer as a fair test of C2C's *training protocol*. It is not a test of C2C's medium. C2C never claims its transferred cache is smaller than the alternative; its latency gain comes from avoiding sequential decoding, not from moving fewer bytes. The compression framing is this project's, and it is this project's to defend. |

### secondary-tier source

| Source | What is taken from it |
|---|---|
| `leonyuhanov/ESP32_ESPIDF_ESPNOW` | Two-role ESP-IDF scaffold with microsecond RTT; adapted for tx_role and rx_role. |
| `thomasfla/Linux-ESPNOW` | Sweep-and-plot methodology for rate versus loss versus latency. |
| `prinnevald/esp-now-eval-tools` | The evaluation scripts released with Urazayev et al.; the closest thing to a reference implementation of an ESP-NOW measurement campaign. |
| `FCam1/ESP32-INA226` | ESP-IDF INA226 driver. Adopted only if it exposes conversion time, averaging mode, high-speed I2C and the Conversion Ready alert; 4.7 requires all four and a default-configuration driver satisfies none of them. |
| `marcoratto/DMFLib-Arduino` | Reference fragmentation design (one sequence byte, no dynamic allocation); the fragmenter follows its shape but is rewritten, so its cost is ownable and chargeable. |
| Lu et al., "Split CNN Inference on Networked Microcontrollers", arXiv:2605.09357 | Evidence that intermediate activations move between MCUs in practice, and the negative space that sharpens Gap 2: Teensy 4.1 over wired 100 Mbps Ethernet with TCP through a PC coordinator, no energy measurement anywhere, and a cost model with a compute term and a per-kilobyte term and no fixed per-transfer term. Their $K_1$, output kilobytes per megacycle, is the closest published analog to the compute-to-payload conversion this project produces, and it is denominated in time rather than joules. |
| Shao and Zhang, BottleNet++ (IEEE ICC Workshops 2020) | The encode, channel, decode decomposition and the feature-compression framing; adopted structurally, priced here on a ledger it never used. |
| TinyML autoencoder deployments on ESP32-S3, e.g. arXiv:2606.02256 | Proof the Condition B encoder is deployable as int8 under TFLite Micro on this chip class; the encoder is adopted practice, not a contribution. |
| Parent build, `c2c_first_principle.md` | The four-condition derivation Section 1 inherits, and the build-order thesis Section 5 inherits: each condition has its own cheapest falsification, and the build order is the ascending order of those costs. |

### tertiary-tier source

| Source | Orientation provided |
|---|---|
| Xin, Fan and Letaief, *Entropy* 26(2):102 | The conceptual vocabulary (Weaver's three levels, semantic encoder, knowledge base, semantic decoder). Two things are taken beyond vocabulary: scheduling and energy optimization is listed there as an open challenge, which is this project's positioning; and the *knowledge base* is the theoretical name for what H_transfer removes, since the survey frames shared knowledge as a precondition for encoder and decoder to understand each other. Its channel-noise machinery is *not* adopted; ESP-NOW's MAC-layer CRC and acknowledgement move most of the noisy-channel problem below this tier, though per 4.6 not all of it. |
| Qin et al., generalized semantic communications | Names the computational cost of semantics as a category in its own framework and never prices it. Gap 6. Its channel-semantics half is out of scope at this tier. |
| SJTU JSCC line and `SJTU-mxtao/semantic-communication-w-codebook` | What the mature end of learned-representation transfer looks like; a source of later ideas, not current requirements. |
| Nordic Power Profiler Kit II product documentation | The instrument the precedent used. Recorded so that the harness in 4.7 is visible as a choice with a stated reason rather than an oversight, and so that its single-rail scope, which is the reason for the choice, is on the record. Optionally a Stage 0 cross-check reference; never part of the method. |
| Community engineering writing: sleep-mode current envelopes, latency benchmark threads, wake-transmit-sleep traces, coexistence notes | Expectation-setting for magnitudes and gotchas. Every figure from this row is borrowed and dies on contact with Stage 2 data. |
| ESP-FAQ, ESP-NOW section | Throughput context and the rationale for the v1.0 length limit. |

---

## 7. Predictions ledger

Recorded before the runs that adjudicate them. Written down afterward, a prediction is worth nothing.

| # | Prediction | Adjudicated at | Outcome |
|---|---|---|---|
| 1 | $E(p)/p$ falls within a frame rather than staying flat | Stage 1 | pending |
| 2 | The fixed per-event term exceeds the per-byte term over a full frame by at least an order of magnitude | Stage 1 | pending |
| 3 | $C_{\mathrm{null}}/C_A$ exceeds one half at the smallest raw payload under consideration, and falls as observation size grows | Stage 1 | pending |
| 4 | A step is visible at $L$ under v1.0 and is separable from the wake term by the $k$-per-wake regression | Stage 2 | pending |
| 5a | $E_{\mathrm{pkt}}$ differs from $E'_{\mathrm{pkt}}$; direction not predicted | Stage 2 | pending |
| 5b | $E'_{\mathrm{wake}}$ exceeds $E_{\mathrm{wake}}$, because the protocol lets S transmit from sleep while R must hold a window open | Stage 2 | pending |
| 6 | Latency is heavy-tailed under unicast; P99 exceeds the median by more than a factor of three at some payload size, and the tail shrinks materially under broadcast | Stage 2 | pending |
| 7 | Retransmission accounts for the majority of the gap between the fixed term and the air time a single successful frame implies | Stage 2 | pending |
| 8 | $E_{\mathrm{enc}}$ is not predicted by operation count within a factor of two | Stage 3 | pending |
| 9 | The step at 250 bytes is large under v1.0 and small or absent under v2.0, since v2.0 adds an element rather than a frame | Stage 4 | pending |
| 10 | The H_ledger margin is an upper bound on the H_transfer margin | Structural; checked at Stage 5 | pending |
| 11 | Decoder_R under H_transfer collapses onto a constant output at least once during training, and the aggregate $Q$ fails to flag it while the output-distribution check does | Stage 5 | pending |
| 12 | At the contract point, the output of R under Condition B equals its output under Condition A, sample for sample. A mismatch is a defect | Stage 3 | pending |
| 13 | At the contract point, `E_proc − E_enc − E_use` is close to zero, reported as a residue with its interval | Stage 3 | pending |

Prediction 11 is inherited rather than invented. The parent build produced that exact failure twice, under two objectives and two corpora, and each time the aggregate read the collapse as a partial score. It is recorded here so that when it happens it is a confirmation rather than a week spent debugging something that is working correctly.

Predictions 12 and 13 follow from `2026-09-26-condition-a-runs-the-same-network-whole-on-r.md`. Predictions 4 and 9 count ESP-NOW payload bytes. Under the ESCP header of 4.1, the first step sits at a raw body of 243 bytes.

### Readings that measurement overturned

Empty at time of writing, since no measurement has been taken. Entries are added here, never removed, and the corrected claim stays visible alongside its replacement.

Four readings have already been overturned by reading rather than by measurement, and are recorded for the same reason:

**That the split-inference line does not meter the radio at all.** Stated in an earlier draft of Gap 2. Contradicted by arXiv:2512.24179 section 5.3, a per-layer ESP-NOW transmission energy profile. The gap survives in the narrower form now stated; the original wording would have been refuted by one table.

**That $E_{\mathrm{proj}}$ belongs to R because the bridge meets the receiver's local context.** Stated in an earlier draft of 4.8. R has no local context in this design. The placement is correct and the justification was not; it is now charged to R because it executes on R.

**That ESP-NOW v2.0 requires ESP-IDF 5.4 or later.** Stated in three places in an earlier draft. The vendor documentation describes v1.0 and v2.0, their interoperation, and their length constants, and says nothing about an IDF version threshold. The claim is withdrawn rather than reworded, because no source for it was ever held.

**That the fragmentation boundary is a frame boundary under both ESP-NOW versions.** Implicit in the earlier form of the Stage 4 control, which treated the v1.0-to-v2.0 change as $L$ moving. Under v2.0 the payload is carried as up to six vendor-specific elements inside one frame, so the 250-byte structure persists as element count. The control is now a test of two different step mechanisms, which is a sharper question than the one it replaced.

---

## Closing note

The parent project earned its rules by breaking things: the extractor that lied politely, the position bug that passed every shape check, the probe that passed for a full run while comparing the wrong quantity. This document is an attempt to pay for fewer of those lessons twice. The contract precedes the hardware (Stage -1), the harness is validated in three directions before it is trusted (Stage 0), the null precedes the comparison it gives meaning to (Stage 1), the cheap probe precedes the expensive sweep, the sufficiency and collapse audit precedes every efficiency claim (4.6), and borrowed numbers are quarantined from measured ones by construction.

One rule is new and belongs to this tier. The terms of the cost model are identified by how the runs are arranged, not by how finely the instrument can see inside one of them (4.2). That is what makes a purpose-built harness tractable: it has to be honest about time, not fast, and honesty about time is the one thing no instrument in reach provides across two nodes at once.

If H1 holds and Condition B clears the break-even inequality at a recovered fraction worth reporting, H_ledger is answered: a physical ledger at the MCU tier can favor a compact learned representation over raw transfer. That is not yet the harder claim. H_transfer is answered separately, at Stage 5, once Encoder_S and Decoder_R stop knowing about each other by construction and only the Projector is left to bridge them.

If both hold, the ledger becomes an engineering document at the MCU tier, the same way a validated projection made one at the model tier, and it does so honestly, having paid the extra cost the alignment problem actually demands rather than assuming it away. If either fails, the failure localizes to a named term in a stated model, and the direction dies cheaply, at the stage that could afford to be wrong.

The parent build ended with a threshold it could not adjudicate, because on a machine with no link the second half of the ledger costs nothing and therefore says nothing. This is the tier where the link costs something. Either outcome serves the compass. The point, as before, is not the table. The point is to stop being surprised by the numbers, at both the cheap layer and the hard one.
