fortunelabs-io/direct-semantic-comm/docs/dsp_first_principle.md

# Direct Semantic Communication on Constrained Hardware: A Thinkbook

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

---

## Preface

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

---

## 1. Problem Statement

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

### 1.1 Why there are exactly three options

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

### 1.2 Why the middle is forced here rather than merely preferred

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

### 1.3 The question

> On two ESP32 nodes linked by ESP-NOW, does a learned intermediate representation actually clear both binding constraints at once, in measured joules and milliseconds, once the sender's encode cost and the receiver's decode cost are both charged against the frames it saves?

Everything below serves that question.

---

## 2. The Gaps

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

### 2.0 Three constraint regimes, not one field

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

---

## 3. The Proposed Solution

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

One experiment, two conditions, four measured phases, both nodes metered.

**Condition A (raw transfer).** S transmits the raw payload. R receives it and runs the full processing step locally. S pays no encode cost. The link pays for every raw byte, fragmented as needed. R pays full processing.

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

At this tier the bottleneck width is free. The latent can be sized, quantized, and layer-selected to land wherever the designer puts it, including deliberately just under the frame limit $L$.

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

### 3.2 R holds no local observation, and the replacement lesson does not transfer intact

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

### 3.3 The encoder

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

### 3.4 Build discipline

Unix discipline governs the build. Each firmware and host component does one thing:

- `payload_gen`: produces payloads of a commanded observation size and content class. Nothing else.
- `fragmenter`: chunks a payload into ESP-NOW frames with one sequence byte, reassembles on the far side. Nothing else. Hand-rolled, so its compute cost is visible and chargeable, not hidden in a vendor component. The sequence byte also carries the application-layer acknowledgement 4.6 requires, since a MAC-layer send success is not an application-layer delivery.
- `phase_marker`: toggles one GPIO per phase transition. Nothing else. This is not stylistic minimalism. The ESP-NOW send callback runs from a high-priority Wi-Fi task and the vendor documentation states that lengthy operations must not happen there, so the marker must be a bare register write and the analysis must happen on the host.
- `tx_role` / `rx_role`: two firmware images, one role each. No dual-mode switches. Ablation variants of each, per 4.2, are separate images rather than compile-time flags on one image.
- `meter_logger` (host side): reads the current trace and the GPIO edges, emits one CSV row per event. Text output, because text composes.
- `analyze` (host side): consumes CSV, emits statistics and plots. Never touches hardware.

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

---

## 4. The Mathematics and the Architecture

### 4.1 Cost model

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

$$n(p) = \left\lceil \frac{p}{L} \right\rceil$$

Transmit-side energy is modeled as three terms, not two:

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

The receive side gets the mirrored model with its own constants:

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

Total cost per delivered observation, both conditions:

$$C_A = E_{\mathrm{tx}}(p_{\mathrm{raw}}) + E_{\mathrm{rx}}(p_{\mathrm{raw}}) + E_{\mathrm{proc}}$$

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

### 4.2 How the terms are identified

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

### 4.3 Every energy figure is reported decomposed

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

### 4.4 The claim under test

Semantic transfer wins if and only if:

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

The wake terms have cancelled. Left side: the net compute premium of the semantic path. Right side: the communication savings, split into a packet-count term and a byte-count term.

The central hypothesis, H1, is that on a low-power connectionless radio the packet-count term dominates the byte-count term, so the win condition is governed by whether the latent fits in fewer frames, not merely fewer bytes. Under H1, $E(p)/p$ is sawtooth-shaped: falling within each frame, jumping at each multiple of $L$.

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

### 4.5 The null, and what a result is reported against

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

$$C_{\mathrm{null}} = E_{\mathrm{tx}}(1) + E_{\mathrm{rx}}(1)$$

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

$$G = \frac{C_A - C_B}{C_A - C_{\mathrm{null}}}$$

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

### 4.6 Sufficiency, and the collapse check

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

$$Q(B) \geq Q(A) - \varepsilon$$

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

Three things are therefore required alongside $Q$, and no efficiency number is admitted without them:

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

### 4.7 System architecture and metering

```
Node S (ESP32)                          Node R (ESP32)
+--------------------+                  +--------------------+
| payload_gen        |                  |                    |
| [encoder: B only]  |                  | fragmenter (rx)    |
| fragmenter (tx)    |   ESP-NOW        | [decoder: B only]  |
| esp_now_send       | ===============> | [processor: A only]|
| phase_marker GPIO  |   n(p) frames    | phase_marker GPIO  |
+---------+----------+                  +---------+----------+
          |                                       |
     current sense on                       current sense on
     the 3.3V rail                          the 3.3V rail
          |                                       |
          +------------> meter_logger <-----------+
                              |
                          CSV rows
                              |
                          analyze
```

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

The sensors are INA226 parts, chosen as catalogue components rather than as an instrument. Everything above them, the capture engine, the timebase, the wire protocol, the calibration procedure and the host tooling, belongs to this project and can be reproduced by anyone reading the published design. The sensor can be substituted later without touching any other layer, which is the point of drawing the boundary there.

Sensor configuration, all of it forced by the datasheet rather than chosen:

- **Shunt-only continuous mode** at the fastest conversion time, 140 microseconds, with averaging set to one. The power-on default is 1.1 milliseconds on each of shunt and bus with shunt-and-bus continuous mode, roughly 2.2 milliseconds per pair, which is longer than an entire 8-byte transmission and would render the transmit phase invisible.
- **Rail voltage treated as a constant**, measured once per run rather than converted per sample. This is what buys shunt-only mode and halves the conversion budget. It is admissible because the rail is regulated; it is checked at Stage 0 and not assumed.
- **High-speed I2C.** A 16-bit register read at 400 kHz fast mode takes on the order of a hundred and twenty microseconds against a hundred and forty microsecond conversion. Fast mode drops conversions. The device supports up to 2.94 MHz.
- **Alert pin configured as Conversion Ready** (the CNVR bit of the Mask/Enable register), routed into the capture engine alongside the phase markers. The INA226 timestamps nothing and I2C reads are not deterministic, so without a hardware edge per completed conversion there is no honest way to place a sample in time. This is the interface between the catalogue sensor and the part of the harness this project owns.
- **Kelvin, four-wire connection to the shunt**, per the datasheet layout guidance.

Two limits are stated here rather than discovered later:

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

### 4.8 The transfer variant (H_transfer)

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

```
Node S (ESP32)                          Node R (ESP32)
+--------------------+                  +--------------------+
| Encoder_S [frozen] |   ESP-NOW        | fragmenter (rx)    |
| fragmenter (tx)    | ===============> | Projector [trained]|
| phase_marker GPIO  |   n(p) frames    | Decoder_R [frozen] |
+--------------------+                  | phase_marker GPIO  |
                                        +--------------------+
```

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

The win condition against Condition A's raw baseline becomes:

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

---

## 5. Proof Steps

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

| Stage | What it can kill | Cost | Void if it fails late |
|---|---|---|---|
| -1 | The packet-count term exists at all | Arithmetic, no hardware | The entire H1 argument, and with it the reason to prefer Option 3 over a byte-count argument |
| 0 | The harness measures the thing it is pointed at, on one honest timebase | Harness build plus validation | Every number in the project |
| 1 | The available range is worth chasing | One cheap run | The direction; Stages 2 onward are then unfunded |
| 2 | The frame boundary has a step, separable from the wake and retransmission terms | The long sweep | The cost model's structure |
| 3 | The two-sided ledger favors the latent | Encoder training and deployment | H_ledger |
| 4 | Each model term survives its own control | Repeats of Stage 3 key points | The attribution of any Stage 3 result to a named term |
| 5 | A bridge can carry a representation across independently trained halves | A second training regime | H_transfer only |

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

What shunt value keeps the expected transmit peak on scale, and where does that place the resolution floor? This is arithmetic over the INA226's full-scale shunt voltage and least-significant-bit against the chip's expected active current, and it produces the stated blind spot of 4.7 as a number rather than a hope.

Deliverable: one table of declared constants and five answers. Cost: an afternoon and no equipment.

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

A cross-check against a commercial single-rail meter, if one can be borrowed, is worth taking. It is not a dependency and it does not enter the method; it converts the Stage 0 claim from agreement with a resistor into agreement with an instrument the field already accepts, on the one case both can measure.

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

**Stage 1: the null and the direction probe.** Two questions, one cheap run, raw transfer only.

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

Report median, P95, P99 per size; the latency distribution is expected heavy-tailed, and under unicast the tail is expected to be governed by retry count rather than by payload size. Deliverable: the sawtooth curve with confidence bands, TX-side and RX-side plotted separately, with $E_{\mathrm{wake}}$ and the retransmission share reported as their own quantities. This is the project's first genuinely novel artifact regardless of what comes after.

**Stage 3: the two-sided ledger, swept (H_ledger).** Introduce the jointly trained encoder on S and the matching decoder on R. Run Conditions A and B on identical input sets. Charge every phase to its node, by firmware-variant ablation per 4.2 rather than by intra-event segmentation. Verify the sufficiency, collapse, and delivery checks of 4.6 per sample before admitting any efficiency comparison.

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

---

## 6. Builder Knowledge

Three classes. Class A is load-bearing: specifications and peer-reviewed measurements this design directly depends on, plus this project's own validated findings. Class B is methodological: repos and papers whose techniques are adopted or adapted. Class C is contextual: surveys and community writing that orient but never justify a design decision. A claim may cite downward for color, never upward for support.

### Class A: Primary

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

### Class B: Secondary

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

### Class C: Tertiary

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

---

## 7. Predictions Ledger

Recorded before the runs that adjudicate them. Written down afterward, a prediction is worth nothing.

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

### Readings that measurement overturned

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

---

## Closing Note

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

---

## Decisions

Choices made here that are hard to reverse, or that a future read would otherwise have to re-derive, are recorded as dated entries in `decisions/`:

| Entry | What it settles |
|---|---|
| `2026-08-09-config-contract-precedes-hardware.md` | Stage -1 as a kill gate |
| `2026-08-09-energy-reported-against-empty-event-null.md` | The null and $G$ |
| `2026-08-09-wake-cost-separate-from-frame-cost.md` | The three-term cost model |
| `2026-08-09-receiver-holds-no-local-observation.md` | Why the replacement lesson does not transfer |
| `2026-08-09-compression-ratio-swept-not-fixed.md` | Stage 3 as a sweep |
| `2026-08-09-terms-identified-by-design-not-by-waveform.md` | Why instrument bandwidth is not on the critical path |
| `2026-08-09-ina226-metering-with-stated-blind-spots.md` | Superseded. The meter, the shunt, and what is not measured |
| `2026-08-09-two-channel-harness-built-in-house.md` | The harness, its scope, and what is deferred |
