fortunelabs-io/direct-semantic-comm/(commit log)

2026-08-09 fix: correcting pcb design tension
2026-08-09 chore: finalizing harness timing budget, -1 contracs and todo for stage 0
2026-08-09 chore: moving stage_minus_1 from todos to contracts
2026-08-09 chore: setting project tree and tidying up device dependency
2026-08-09 docs: add git and issue standard operating procedure
    Scope is one developer. Every rule exists because the repository is the
    evidence chain: which commit produced this number, and what was the
    specification when it did.
    git_sop.md fixes branch naming on the mise task name, adds `gate` as a
    commit type distinct from `feat` because it adds evidence rather than
    capability, and states three atomicity rules. The load-bearing one is
    that a specification change never shares a commit with the result it
    grades, since a criterion edited beside the number it judges is a
    criterion that could have been edited to fit.
    issue_sop.md places gate status in the tracker and nowhere else, which
    is what stage0_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
2026-08-09 adr: choose STM32 for the capture engine, part still open
    Not a capability decision. RP2040 meets all four requirements of Tier 0
    gate 1 on paper, and the record says so, because a reader who cannot
    tell a capability argument from a sourcing one will apply this entry to
    a case it does not cover.
    The two grounds are sourcing and established skill, both inherited from
    the in-house harness entry: ten boards are spares only if all ten can be
    populated, and the capture firmware is the highest cost-of-failure
    software in the project, so a second SDK does not get learned inside it.
    Records the argument deliberately not made. Timer input capture was
    available as a justification and is not used, be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
2026-08-10 chore: add the hardware design pipeline, erc through fabrication parity
    mise run erc | drc | hw | fab | fab-parity
    .github/workflows/hardware.yml, hardware-fab.yml
    One checker, hardware/check.py, run identically at the desk and in CI so that
    "clean locally" and "clean in CI" are one claim rather than two that agree.
    kicad-cli pinned to 9.0.x and asserted before anything is reported; CI runs
    kicad/kicad:9.0.9, matching this machine.
    Four outcomes kept apart, because "the board is wrong" and "the checker could
    not run" otherwise get the same red tick and call for opposite responses:
    0 clean, 1 violations, 2 nothing to check, 3 cannot check.
    Exit 2 fails rather than passing. Every command he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
2026-08-11 spec: name the capture firmware toolchain as bare metal
    The capture firmware row named CubeMX plus CMake and made the whole entry
    conditional on a part that was not yet selected. Both are now settled:
    the part is STM32F411CEU6 and the firmware is bare metal with no vendor
    HAL, per the two ADRs of 2026-08-12.
    Lands on its own and before the firmware it grades, per the atomicity
    rule in docs/sop/git_sop.md. A criterion edited alongside the thing it
    judges cannot be shown not to have been edited to fit it.
2026-08-11 adr: fix the capture engine part and its firmware style
    Two records, both written while the argument was open:
    - the part is STM32F411CEU6 (LCSC C60420), chosen over STM32F401CEU6 on
    stock depth alone; both clear the four requirements from the datasheet
    - the firmware is bare metal, no CubeMX and no vendor HAL
    Supersedes 2026-08-09-capture-engine-is-stm32-part-still-open.md, which
    fixed the family and left the part open.
2026-08-11 feat: add the bare metal capture engine firmware for STM32F411CEU6
    Clock tree, two I2C masters and a blink, enough to satisfy the Tier 0
    gate once a board and an ARM toolchain are present. Not yet built: no
    arm-none-eabi-gcc on this machine.
    Three things the datasheet decided against the first draft of this code,
    all read from DocID026289 Rev 4:
    - PB4 carries I2C3_SDA at AF9, not AF4. Table 9 heads AF04
    "I2C1/I2C2/I2C3" and AF09 "I2C2/I2C3", so I2C3 appears in both columns
    and the applicable one is per pin. AF04 on PB4 is blank, so the second
    bus would have initialised cleanly, reported no error, and never
    reached the pad.
    - SYSCLK is 96 MHz, not 100. SYSCLK = VCO/PLLP with PLLP i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
    [main.c, register_map.h, sensor.c, sensor.h, timebase.c, timebase.h, timing_budget.h]
2026-08-11 chore: wire the toolchain gate to its capture script and test
    mise run toolchain ran `echo OPEN ... && exit 1`. It now names the part,
    as the specification requires, and runs the capture script followed by
    the test, in that order and not collapsed: the script captures and may
    prompt, the test is pure and silent on success, and a gate closes on the
    test's exit code, so the test has to be able to fail on a file the script
    was happy to write.
    Committed before the run, never after, per docs/sop/git_sop.md. A script
    committed alongside the capture it produced cannot be shown to be the
    script that ran.
    Three corrections to the capture script:
    - An ERR trap replaces per-step guards. cmake config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
2026-08-11 spec: split the Tier 0 gate at the line the tier is defined by
    Tier 0 is "nothing powered" (line 130) and its only gate required a blink
    to flash on a board (line 143). Flashing is powering. The gate could not
    satisfy the constraint of the tier containing it, and that was true
    regardless of what hardware was on hand.
    The cost was not tidiness. "Nothing below an open gate gets run", so one
    gate that needed an ST-Link blocked Tiers 1 through 3 entirely, including
    every item unrelated to whether an LED blinked.
    Split along the claim, not along convenience:
    - Tier 0 `toolchain` keeps the part's datasheet claim. The limits are
    transcribed into timing_budget.h and the clock plan is asserted a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
2026-08-11 chore: rebuild the toolchain gate as a paper check, add blink for Tier 1
    Follows the split in 5fc4d7e. Committed before either gate runs, never
    after: a script committed alongside the capture it produced cannot be
    shown to be the script that ran.
    `toolchain` no longer builds or flashes anything. The check is a compile:
    scripts/toolchain_record.c includes timing_budget.h, whose static
    assertions compare the clock plan against limits transcribed from
    DocID026289 Rev 4, and a plan violating a limit does not build. It is
    built with the host compiler on purpose, since that header is integer
    arithmetic with nothing target-specific in it, so the host evaluates the
    same assertions the cross compile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
    [sensor.c, sensor.h, toolchain_record.c]
2026-08-11 fix: use tree_dirty in the assemble stage too
    The previous commit replaced the bare porcelain call in write_failure but
    missed the one in assemble, which spells the variable GIT_DIRTY rather
    than git_dirty. The pass path therefore still counted its own output and
    the gate still failed on every run after the first.
    Caught by running the gate three times instead of once. A fix verified by
    a single run would have looked correct.
2026-08-11 gate: close toolchain, clock plan holds against every datasheet limit
    mise run toolchain
    results/stage0_toolchain.json
    mise run doctor: clean
    Prediction held, with one error of fact in the prediction itself.
    Held: the clock plan satisfies every limit transcribed from DocID026289
    Rev 4, and the two I2C masters are on separate pins with their alternate
    function numbers recorded, PB4 at AF9 and not the AF4 its column header
    suggests. Both were the substance of the prediction and both are in the
    result file.
    Wrong: the prediction said fourteen static assertions. There are
    thirteen. The miscount is left standing in the issue rather than edited,
    because a prediction corrected after the run it w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
2026-08-16 docs: add the high-level design, the layer between the thinkbook and the ADRs
    What the system is: components, and the interface at every boundary that
    crosses a component, a board, or a wire. Holds no status and no
    measurements, so it competes with none of the four existing document
    kinds.
    Derived from the eleven ADRs, DocID026289 Rev 4, SBOS547B and the Tier 0
    firmware skeleton. Marked Draft: every recommendation in it is a candidate
    for an ADR or for the open item it names, and none of them closes one.
    The pin allocation stays with harness_spec.md, and the meaning of b2 stays
    with phase_code_map.md.
    Seven open items, ranked by the cost of finding out late. O1 is the one
    worth reading fir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
2026-08-16 adr: the phase code is three parallel bits per node, not serialised
    Closes the second of the three Tier 0 implementation choices. The argument of
    record is issue #2.
    Rejected: one data line plus a strobe, on three independent grounds. It inserts
    a latency that would have to be characterised and subtracted from every phase
    boundary; the shift-out is more than one masked register write and would not
    stay inside the ESP-NOW send-callback discipline; and a code arriving over
    several bit times cannot be read atomically, which reintroduces at another layer
    the failure Gray ordering was adopted to remove.
    Binds the pin map: each node's three bits contiguous within one GPIO port.
2026-08-16 spec: close the three Tier 0 choices, and the phase code map at six states
    Records the three decisions where the specification names them, and closes
    phase_code_map.md with every open cell filled.
    The third choice, bench sensor source, is a sourcing verification rather than a
    decision, so it gets no record of its own. Confirmed: the part is the bare
    INA226AIDGSR in VSSOP-10, LCSC C49851, and no breakout is used at any tier, so
    there is no inherited shunt and no product listing is relied on. Priced here
    rather than discovered later: 0.5 mm pitch cannot be breadboarded, so Tier 1 and
    Tier 2 need a hand-assembled sensor carrier with the same Kelvin sense
    requirement as the fabricated board.
    C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
2026-08-16 docs: stop the HLD preface rendering as a heading
    Carries the working-tree edit that unitalicised the preface and tightened it
    under the status line, and fixes what that edit exposed.
    Under CommonMark, which is what GitHub renders with, a `---` on the line
    immediately after a paragraph is a setext heading underline rather than a
    thematic break, and it consumes the whole paragraph. The preface was rendering
    as an h2 and the rule was not appearing at all. Removing the blank line after
    the status line had widened the problem to include that line too.
    Verified against a CommonMark implementation rather than by eye, because
    python-markdown renders the same input as paragraph plus rule and would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
2026-08-16 spec: cite the link gate by handle, not by tier position
    Closes the first half of O7. The contract cited "Stage 0 item C3" for the
    ESP-NOW version check, and the third item of Tier 2 is the radio-disabled image,
    not the version check. It now names the `link` gate, which is the identity the
    issue SOP fixed on and the one name that cannot drift when a gate is inserted
    above it.
    The issue SOP carried this as a discrepancy to reconcile. Rewritten as the
    worked example of why gates are cited by handle, since a note describing an
    unresolved problem outlives the problem otherwise.
2026-08-16 adr: mark the STM32 family entry superseded in part
    Closes the second half of O7. The entry still read Accepted, though both clauses
    that make its title true are gone: the part number closed with STM32F411CEU6,
    whose record declares Supersedes: against it, and the toolchain clause was
    revised to bare metal with no CubeMX, whose record declares Amends: against it.
    The convention was already followed elsewhere, so this was an oversight rather
    than a different practice.
    A reader landing on the file directly took away two things that are not true of
    this project: that the part is open, and that the toolchain is CubeMX plus
    CMake. The status line now points forward to both successors and says wh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
2026-08-16 docs: close O7 in the high-level design
    Both discrepancies are fixed on main. Recorded as closed rather than deleted,
    because a reader landing on one file rather than the set is the failure mode
    section 7 exists to catch, and an item that vanishes teaches nothing about how
    it was caught.
2026-08-17 docs: split the decided part from the still-open toolchain
    The parts table carried "STM32, part open, Tier 0 gate 1" after the part
    was fixed to STM32F411CEU6 by the 2026-08-12 ADR and after `toolchain`
    closed on real evidence in results/stage0_toolchain.json. Name the part
    and drop the gate qualifier.
    The layout row conflated two things no longer in the same state: the part
    is pinned, while arm-none-eabi-gcc is genuinely unpinned because it has
    never run on this machine. Read as one phrase, "capture toolchain open"
    could mean either the part was never chosen or the compiler is missing.
    Split them, and attribute the compiler to `blink`, which is the gate that
    needs it. ESP-IDF stays open bu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
2026-09-09 docs: freeze the whole Accepted ADR, not only its Decision section
    The codex ADR SOP states an Accepted ADR is never edited afterward. The
    git SOP had narrowed that to the Decision section, which would permit
    rewriting Context, Alternatives, and Consequences after acceptance and
    weaken the guarantee the codex requires. The whole record is now frozen;
    the status line is the only exception, and only to record supersession,
    which is what the STM32 entry already does.
2026-09-09 gate: re-run toolchain, same result at a newer capture commit
    Re-ran the toolchain gate. Every measured field is unchanged — same
    part, same clock plan against DocID026289 Rev 4, same I2C pin and
    alternate-function assignments, status pass. Only the provenance moved:
    captured at 0761a0f on 2026-08-17, not 9e7b104 on 2026-08-11.
    Not an invalidation. #1 stays closed: nothing about the gate's premise
    changed — no firmware fix, no board revision, no criterion corrected —
    so under issue_sop this is a re-capture, not a reopen. The prior capture
    remains in history at 6557fd5.
    Re #1
    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
2026-09-10 adr: record STM32F411 pin assignment, populate harness_spec
    Add the pin-assignment ADR (Proposed) and populate harness_spec.md, the
    reserved pin-allocation contract (O3). Reconcile both to committed firmware
    and the HLD:
    - I2C: Channel A on I2C1 (PB6/PB7, AF4), Channel B on I2C3 (PA8 AF4 / PB4
    AF9), matching sensor.h; drop the draft I2C2 (PB10/PB3).
    - Timebase: TIM2, SYSCLK 96 MHz, PSC 95 for a 1 MHz tick, per timing_budget.h
    and timebase.c; the prescaler is decided, not PENDING.
    - ALERT: reframe as INA226 conversion-ready (CNVR), rising edge on EXTI0/EXTI1.
    - Phase code: allocate PA2-PA7 (the withdrawn PA0-PA5 shifted up two to clear
    the CNVR pins on EXTI0/EXTI1), proposed pending th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
2026-09-10 docs: sync dsc_first_principle Decisions table with current ADR set
    Add the six capture-engine/harness ADRs (Aug 12 - Sep 9) that were
    missing from the table, annotate the two non-Accepted statuses
    (part-still-open superseded in part; pin-assignment proposed), and
    fix the directory pointer from decisions/ to adr/.
2026-09-13 docs: add hardware HLD for the capture-engine board (Obol Harness v1)
    Board-level support-component design and BOM for the STM32F411 capture
    engine. Remote-sense topology over PCA9615 differential I2C; decoupling,
    LDO, crystal, pull-up and termination counts derived from declared
    formulas; part selection and bound values in a BOM section. Locks native
    USB CDC, an 8 MHz HSE crystal, and sense-side-only power.
2026-09-13 adr: accept clock source, PCA9615 remote link, and USB transport
    Three ADRs from the hardware HLD, accepted on primary-source datasheet
    checks (STM32 DocID026289 Rev 7 Table 8; NXP PCA9615 Rev 2):
    - HSE 8 MHz crystal replaces the HSI PLL source for USB compliance and
    timebase accuracy (downstream frequencies unchanged, PSC 95 stands)
    - remote INA226 reached over a PCA9615 differential I2C link on a
    per-node sense board
    - native USB CDC transport; the bare-metal no-HAL rule is scoped to the
    measurement path, admitting an audited USB stack for transport
    Amends 2026-08-12-capture-engine-firmware-is-bare-metal (status line
    points forward).
2026-09-15 docs: trim harness_spec to a decisive pin map, move verification to the ADR
    Reshape harness_spec.md so it carries only the pin allocation, leaving the
    board/BOM to hardware_hld.md and the clock plan to timing_budget.h. The overlap
    with the hardware HLD is now clean: HLD owns board and BOM, header owns the
    clock, this file owns the pins.
    harness_spec.md:
    - Condense the clock tree (old §5) to a pointer to timing_budget.h; drop the
    HSI hypothesis and the 96-vs-100 MHz reasoning.
    - Remove the Open items and Verification sections and the Status "Binding?" /
    proposed / pending hedging; the pin tables are now stated as decided.
    - Drop the Origin columns from the pin tables.
    - Point verificati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
2026-09-16 docs: gate harness HLD fabrication on a proving spike, add open items
    hardware_hld.md read as ready-for-fab on datasheet reading alone, though its
    own Status line says no cell is MEASURED. Add §15: a throwaway spike (WeAct
    F411 Black Pill + INA226 breakout, per git_sop spike/) placed in front of the
    fab trigger to close O1 and the architecture gates (rate/dropped/wrap/jitter)
    and demonstrate the USB CDC transport (R1) on silicon. The 25 MHz Black Pill
    reaches the same 96/48 MHz tree as the 8 MHz clock ADR; only PLLM differs.
    No Accepted decision in §13 is reversed: the clock, USB, and PCA9615 choices
    remain the plan for the fabricated board. §15.2 states the hard boundary: the
    breakout c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
2026-09-17 docs: correct American spelling and drop two intensifiers in the thinkbook
    Language inspection against the Fortune Labs writing standard.
    Spelling (standard American, and internally consistent):
    - artefact -> artifact (matches "artifact" already used in Stage 2)
    - judgement -> judgment
    - cancelled -> canceled
    - catalogue -> catalog (two instances in 4.7)
    Empty intensifiers removed:
    - 1.3 boxed question: drop "actually" (the empirical sense is already
    carried by "in measured joules and milliseconds")
    - Stage 2 deliverable: "genuinely novel" -> "novel"
    Prose only; no specification, figure, or decision changes.
2026-09-17 docs: sentence-case the thinkbook headings
    Fortune Labs writing standard requires sentence case in headings. The
    top-level section headings and the Class A/B/C headings carried title
    case while every subsection heading was already sentence case; this
    aligns them.
    Case-only changes: GitHub heading anchors are unchanged, and no
    cross-reference in the repo depends on the heading prose (section
    references cite numbers, the body cites "Class A/B/C" by letter).
2026-09-17 docs: remove em dashes and en dashes from the system HLD
    Fortune Labs writing standard bans the em dash outright. Thirty were
    present; each is replaced with the punctuation the sentence logic wants
    (period, colon, comma, or semicolon), the four empty-table-cell markers
    become a plain hyphen, and the three en-dash pin/EXTI ranges become
    ASCII hyphens (matching harness_spec.md).
    The O1/O2/O5/O6 and R1-R5 label dashes become periods, matching the
    O3./O4./O7. label style already used in the same document.
    Punctuation only; no figure, decision, or spelling change.
2026-09-17 docs: sentence-case the HLD title and drop one intensifier
    - Title: "High-Level Design" -> "high-level design" (sentence case in
    headings; project name kept capitalized).
    - O1: drop "actually" from "actually self-clear"; the empirical sense is
    carried by the question itself.
    Prose only.
2026-09-17 docs: American spelling in the harness pin map
    Fortune Labs writing standard requires standard American spelling.
    initialised -> initialized; utilisation -> utilization. Aligns with the
    rest of the now-American corpus.
    Spelling only.
2026-09-17 docs: sentence-case the timing-budget title and drop one intensifier
    - Title: "Signal Inventory and Timing Budget" -> sentence case, matching
    the section headings.
    - "actually written out" -> "written out" (empty intensifier).
    Prose and heading only.
2026-09-22 chore: scaffold the KiCad project and fab directories
    harness/hardware/kicad/ will hold the one KiCad project: .kicad_pro,
    .kicad_sch, .kicad_pcb, and .kicad_dru, kept colocated because check.py
    derives the schematic and layout as siblings of the .kicad_pro it discovers.
    harness/hardware/fab/ will hold the generated Gerbers, drill, position, BOM.
    Each folder carries a README, which is also what makes the otherwise-empty
    directory tracked. No .kicad_pro yet, so `mise run hw` still exits 2 (absent),
    which is correct. reports/ stays git-ignored; fab/ is tracked per
    harness/.gitignore.
2026-09-22 docs: align hardware status lines to the scaffolded KiCad project
    The obol-harness KiCad project was scaffolded on 2026-09-22, so the docs
    that assert "no project exists" and "mise run hw exits 2 (absent)" are
    stale. hw now exits 1 on the empty board outline (no Edge.Cuts) until the
    layout is drawn; erc is clean.
    - README.md: the status line and the exit-2 note now say a project
    exists and no command returns 2.
    - kicad/README.md: "Nothing is committed here yet" becomes the project
    exists on disk, not yet committed.
    - hardware_hld.md: the one cross-reference that called the project
    nonexistent now tracks it as scaffolded and under design.
    Prose only. No BOM value or decision changed.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
2026-09-22 docs: expand the PCB review checklist into the full pre-fab walk
    harness_spec §6 names review_checklist.md the authoritative board-review
    gate, but it covered only the two silent-bias electrical checks. Build it
    out into the complete engineer walk before Gerbers:
    - block-by-block confirmation that the schematic realizes hardware_hld
    §4-§11, with the datasheet traps called out (VCAP_2 absent, VDDA
    filtered not regulated, both CC pins, PCA9615 dual-supply decoupling);
    - the CNVR external-vs-internal pull-up divergence to resolve at the walk;
    - a pin-map hand-off to harness_spec §6;
    - the fab-trigger preconditions from hardware_hld §12/§15: primary-source
    checks, the three board AD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
2026-09-22 chore: commit the obol-harness KiCad project scaffold
    Add the empty project (.kicad_pro, .kicad_sch, .kicad_pcb) so the
    capture-engine board exists in the repo, not only on disk, matching the
    status prose committed in 271d582.
    check.py now reports exit 1 (drc: malformed outline, no Edge.Cuts) rather
    than exit 2 (absent): erc is clean on the empty schematic and drc carries
    the single expected empty-board error until the layout is drawn. Backups
    and reports/ stay git-ignored per harness/.gitignore.
    [obol-harness.kicad_pcb, obol-harness.kicad_sch]
2026-09-22 hw: STM32 MCU block schematic (block 1 of the capture engine)
    U101 STM32F411CEUx with full support: decoupling (100 nF per VDD/VBAT/NRST,
    4.7 uF bulk), VDDA ferrite filter (FB1 + 1 uF + 10 nF), VCAP_1 2.2 uF, the
    8 MHz HSE crystal (Y1 + 2x 27 pF), reset and boot buttons (SW1/SW101),
    SWDIO/SWCLK/BOOT0 pulls (R101-R103), and the SWD header (J1).
    Hierarchical design: every signal leaving the sheet is a hierarchical label
    matching the harness_spec symbolic names (I2C_A/B, CNVR_A/B,
    PHASE_A/B_BIT0-2, USB_DM/DP, VBUS_SENSE, LED_HB/ACT, TRIG, SPARE).
    Pin numbers verified against DocID026289 Rev 7 Table 8. VDD is three pins
    (24/36/48), which corrects hardware_hld Section 5's "two VDD" undercount;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
    [obol-harness.kicad_sch]
2026-09-24 docs: correct the VDD pin count in hardware_hld section 5 (two to three)
    DocID026289 Rev 7 Table 8 bonds three VDD pins on UFQFPN48 (24, 36, 48).
    Section 5 recorded two (24, 36) and missed pin 48, so the close-in
    decoupling count was one capacitor short. Caught by placing the part in
    KiCad while drawing the STM32 block (5466852), which is the check a
    datasheet reading does not replace.
    Corrected in the four places the count reached:
    - section 5: three VDD pins, 100 nF x3, close-in total 100 nF x5, plus a
    row recording VSS (23, 35, 47), the exposed pad and VSSA (8) as grounded
    with no component, and a dated correction note.
    - section 11: MCU decoupling 100 nF x5; capacitor roll-up 15 to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
2026-09-24 hw: split the capture engine into hierarchical sheets and wire the root
    The flat STM32 page becomes five sheets under a root that carries no
    components: MCU (1XX), Power (2XX), USB-C (3XX), Channels (4XX) and
    IO (5XX). Both channels share one drawing on the Channels page and are
    separated by a +50 refdes offset, A at 401-413 and B at 451-463.
    Verified against the exported netlist rather than ERC alone, since the
    errors that matter here pass ERC clean. Two did, and were fixed: the
    connector VBUS pins were wired to the sense divider midpoint, which
    would have run all board current through 10k and put 5 V on PA9, and
    the SWD pulls were in series with SWDIO and SWCLK rather than pulling
    to a ra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
    [channel.kicad_sch, io.kicad_sch, mcu.kicad_sch, power.kicad_sch, usb_c.kicad_sch]
2026-09-24 chore: stamp exported schematic PDFs with the release and commit hash
2026-09-24 hw: set the blue indicator resistor to 330R and fill two footprints
    D503 is blue, so the 1k derived in hardware_hld section 8.2 for a 2.0 V
    forward drop leaves almost nothing across the resistor on a 3.3 V rail.
    330R restores roughly the 1.2 mA the other two indicators draw.
    C402 and C452, the V_DD(B) decoupling on each channel, get their 0402
    footprints. Three symbols still have none: SW501, SW101 and FB101.
    [channel.kicad_sch, io.kicad_sch, mcu.kicad_sch, obol-harness.kicad_sch, power.kicad_sch, usb_c.kicad_sch]
2026-09-26 adr: record eight decisions of 2026-09-26
    The ESCP wire format, the encoder toolchain, the search space, and where
    the width sweep sits. Each record carries the alternatives it rejected.
    Configuration binds at build time, one static image per configuration.
    Binding (b), a runtime policy table, is recorded and not designed.
    Algorithm 1 returns B_WINS, A_COST, or A_QUALITY and records the whole
    candidate table, because a boolean verdict merges a quality loss with a
    cost loss. The encoder toolchain is ESP-DL v3 with ESP-PPQ, both pinned.
    The cut is fixed at an injected linear bottleneck and the search runs
    over (w, b), since a layer search tends toward sending the decision.
    ESCP payload packin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
2026-09-26 docs(hld): add the ESCP wire, the pre-computed artifacts, and Algorithm 1
    Section 4.5 states the ESCP frame between S and R: the candidate header
    layouts, the decided layout (i') with its field table, the receive rules,
    the fields left out, the ACK, the bit-level rules, and the test vectors.
    Section 4.6 states the pre-computed artifacts, binding (a) and binding
    (b), and the artifact table. Appendix C carries Algorithm 1 in 34 lines
    with its notation table and the three verdicts, and is the source of
    record for the procedure; thinkbook 4.9 is the source of record for the
    mathematics.
    Section 1 names Stage 3b in the v1 scope. Section 2 gains one derivation
    row per new ADR. Section 3.1 updates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
2026-09-26 spec: count Q1 frames with the ESCP header
    The frame count becomes n(p) = ceil((p + 6) / (L - 1)). The contract
    latent is 71 bytes on the wire, still one frame under either version. The
    96 x 96 image row moves from 37 frames to 38, which puts it above the
    32-frame cap of the header, and the range of the frame difference becomes
    1 to 37. The thresholds move to above 243 B and 0.20 s under v1.0, and
    above 1,463 B and 1.22 s under v2.0.
    The answer to Question 1 does not change. It is still yes for all three
    candidates under v1.0, so this amendment restates the arithmetic and does
    not reopen the gate.
    The declared constants gain the ESCP header at 1 B per frame and 6 B per
    message. The reopeni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
